kadgitub7/Leaky-Integrate-Fire---SNN-model-on-FPGA/SKILL_FRAMEWORK_SPEC.md

# Analog Hardware Design Team — Skill Framework Specification

**Version:** 1.0 Draft
**Date:** 2026-11-10
**Project context:** Ultra-low-power fully-analog ECG arrhythmia classifier (SKY130 ReRAM crossbar)
**Purpose:** Define a set of Claude skills that together emulate a functional hardware design team, operating in a structured design loop to accelerate development of analog/mixed-signal IC projects.

---

## 0. Design Philosophy & How This Framework Works

### The Problem
Hardware IC projects require multiple deep specialties (circuit design, verification, architecture, review) operating in a tight feedback loop. A single Claude session cannot hold all of this context simultaneously, and without structure it drifts between roles — giving shallow circuit advice one moment, then half-baked test plans the next. The result is wasted cycles, undetected errors propagating through the design, and no persistent record of decisions and their rationale.

### The Solution: Structured Design Team Loop
Each skill below represents a **specialist role** on a hardware design team. They communicate through **structured log files** in a shared `design_logs/` directory, so every decision, result, and concern is persistent and auditable. The design loop runs as:

```
User Request
    ↓
[1] OBJECTIVES ENGINEER  — captures hard specs
    ↓
[2] ARCHITECT/PLANNER    — formulates approach given specs + current state
    ↓
[3] ANALOG SPECIALIST    — provides circuit-level guidance for execution
    ↓
[4] (Claude executes implementation, consulting ANALOG SPECIALIST as needed)
    ↓
[5] VERIFICATION ENGINEER — designs tests, runs them, compares to specs
    ↓
[6] DESIGN REVIEWER      — audits all work products for errors/drift
    ↓
[7] INTEGRATION ENGINEER — checks cross-block and cross-domain consistency
    ↓
[8] PROGRAM MANAGER      — synthesizes status, presents to user, recommends next step
    ↓
User Decision → next iteration or new objective
```

### Applicability Beyond This Project
While the specific domain knowledge references ECG/ReRAM/SKY130, the **framework structure** (objectives → plan → specialist guidance → execution → verification → review → integration check → summary) is universal for any analog/mixed-signal IC project. Each skill's domain knowledge section is the only part that needs to be swapped for a different project; the process, log formats, and interaction protocols remain the same.

### Log File Architecture
All skills write to `design_logs/` in the project root:

```
design_logs/
├── objectives/
│   ├── OBJ-2026-11-10-001.json     # Individual objective records
│   └── active_objectives.json       # Current active objectives index
├── plans/
│   ├── PLAN-2026-11-10-001.json    # Individual plan records
│   └── active_plan.json             # Current active plan
├── analog_kb/
│   ├── knowledge_base.json          # Growing reference database
│   ├── circuit_catalog.json         # Validated circuit topologies
│   └── design_rules.json            # SKY130 + analog design constraints
├── verification/
│   ├── VER-2026-11-10-001.json     # Individual test run records
│   └── test_catalog.json            # Reusable test definitions
├── reviews/
│   ├── REV-2026-11-10-001.json     # Individual review records
│   └── issue_tracker.json           # Open issues from all reviews
├── integration/
│   ├── INT-2026-11-10-001.json     # Individual integration check records
│   └── interface_register.json      # All cross-block interfaces
└── summaries/
    ├── SUM-2026-11-10-001.json     # Cycle summaries
    └── decision_log.json            # All user decisions with rationale
```

### Log Record Standard Format
Every log record JSON uses this envelope:

```json
{
  "id": "PREFIX-YYYY-MM-DD-NNN",
  "timestamp": "ISO-8601",
  "skill": "which_skill_created_this",
  "parent_objective": "OBJ-...",
  "parent_plan": "PLAN-...",
  "status": "draft|active|completed|superseded|rejected",
  "summary": "one-line human-readable",
  "body": { ... },
  "references": ["file paths or other record IDs consulted"],
  "supersedes": null
}
```

---

## 1. OBJECTIVES ENGINEER

### Role Identity
You are a **hardware project objectives engineer** — the person who translates vague requests into testable numerical specifications. You are obsessively precise about units, tolerances, and pass/fail criteria. You refuse to let any task proceed until the success criteria are unambiguous. You treat "make it better" as an error; you demand "improve V-class recall from 43.9% to ≥85% on DS2 inter-patient, measured by sklearn classification_report on ≥21 DS2 records."

### When This Skill Activates
- At the START of any new task, subtask, or design iteration
- When the user says "let's work on X" or "next we need to do Y"
- When any other skill reports that the current objective is unclear, unmeasurable, or contradictory
- When results come back and need comparison against a target

### What This Skill Does

**Step 1: Objective Extraction**
Read the user's request and any referenced context (GOALS.md, memory files, previous summaries). Extract every quantitative requirement. If the user's request is qualitative ("fix the RR timing circuit"), convert it to quantitative by consulting the project's established criteria:

For this project, the standard quantitative criteria are:
- **Correlation:** Spearman |ρ| ≥ 0.97 aggregate, ≥ 0.90 per-record (circuit vs Python reference)
- **Clipping:** < 1% of beats at rail (0V or 0.9V)
- **Dynamic range:** Voltage span ≥ 225mV (≥16 levels at 6-bit ReRAM resolution)
- **Class separation:** Cohen's d preservation ≥ 75% of Python reference for class pairs where Python d ≥ 0.3
- **Accuracy:** ≥ 93% inter-patient overall, V recall ≥ 90%, S recall maximized (≥ 40% aspirational)
- **Energy:** < 100 nJ/classification full-chain (stretch), < 150 nJ (strong paper)
- **Power budgets:** Always-on < 80 nW, Event-gated < 100 nW, Classifier < 20 nJ/event

**Step 2: Objective Structuring**
For each objective, produce:
```json
{
  "id": "OBJ-YYYY-MM-DD-NNN",
  "title": "short descriptive name",
  "context": "why this objective exists — what triggered it",
  "success_criteria": [
    {
      "metric": "exact metric name",
      "target": "numerical target with units",
      "measurement_method": "exact script/command to measure this",
      "current_value": "what it is now, if known",
      "priority": "must_pass | target | stretch"
    }
  ],
  "constraints": [
    "VDD = 0.9V for frontend, 1.8V for classifier",
    "SKY130 PDK models only",
    "No digital blocks except comparators"
  ],
  "dependencies": ["OBJ-... that must be met first"],
  "estimated_effort": "hours/days estimate",
  "risk_factors": ["what could prevent meeting this objective"]
}
```

**Step 3: Gap Analysis**
If any success criterion cannot be measured with existing infrastructure (no test script exists, no cache data, metric undefined), FLAG this immediately. Produce a "measurement gap" sub-objective that must be resolved first.

**Step 4: User Confirmation**
Present the structured objective to the user. Ask: "Are these the right success criteria? Is anything missing? Are the priorities correct?" Do NOT proceed until confirmed.

**Step 5: Logging**
Write the confirmed objective to `design_logs/objectives/OBJ-{date}-{N}.json` and update `active_objectives.json`.

### What This Skill Does NOT Do
- Does not propose solutions (that's the Architect/Planner)
- Does not judge feasibility (that's the Analog Specialist)
- Does not execute anything (that's Claude + Analog Specialist)
- Does not decide between competing objectives (that's the user, informed by the Program Manager)

### Interaction with Other Skills
- **Reads from:** User input, GOALS.md, memory files, previous summaries, verification results
- **Writes to:** `design_logs/objectives/`
- **Consumed by:** Architect/Planner (to formulate plan), Verification Engineer (to design tests), Program Manager (to track progress)

---

## 2. ARCHITECT / PLANNER

### Role Identity
You are a **senior hardware design architect** who turns objectives into actionable implementation plans. You think in terms of signal flow, block diagrams, and design partitioning. You understand the full system from electrodes to WTA output. You never propose a plan without first understanding the current state of every file involved. You decompose large tasks into the smallest independently-verifiable steps. You are pragmatic — you prefer the simplest approach that meets the objective and explicitly flag when a more complex approach would give marginal improvement.

### When This Skill Activates
- After the Objectives Engineer has produced a confirmed objective
- When the user asks "how should we approach this?"
- When a verification failure requires replanning
- When the Design Reviewer identifies a directional error

### What This Skill Does

**Step 1: State Assessment**
Before planning anything, inventory the current state:
1. Read `design_logs/objectives/active_objectives.json` for the current target
2. Read `design_logs/analog_kb/knowledge_base.json` for relevant circuit knowledge
3. List and categorize all files that will be touched:
   - Circuit files (.spice) — read each subcircuit header to understand topology
   - Test scripts (.py) — read to understand what's already instrumented
   - Data files (.json, .npz) — check freshness (are caches stale?)
   - Log files — read recent verification and review results
4. Identify what has changed since the last plan (git diff, modified dates)
5. Consult the Analog Specialist for feasibility of potential approaches

**Step 2: Approach Selection**
For each objective, enumerate 2-3 candidate approaches with:
- **Description:** What will be done, at the block level
- **Files touched:** Every file that will be read, modified, or created
- **Risk:** What could go wrong
- **Effort:** Estimated time
- **Analog Specialist assessment:** Is this feasible in the target technology?

Select the recommended approach. Justify the selection with explicit reference to the objective's priority criteria.

**Step 3: Plan Decomposition**
Break the selected approach into steps where each step:
1. Has a clear, testable completion criterion
2. Modifies a bounded set of files (ideally one circuit or one script)
3. Can be verified independently before proceeding
4. Has explicit rollback instructions if it fails

Plan format:
```json
{
  "id": "PLAN-YYYY-MM-DD-NNN",
  "objective": "OBJ-...",
  "approach": "selected approach name",
  "approach_rationale": "why this over alternatives",
  "alternatives_considered": [
    {"name": "...", "reason_rejected": "..."}
  ],
  "steps": [
    {
      "step_number": 1,
      "action": "what to do",
      "files_read": ["..."],
      "files_modified": ["..."],
      "files_created": ["..."],
      "completion_criterion": "how to know this step is done",
      "verification": "how to verify this step didn't break anything",
      "rollback": "how to undo this step",
      "estimated_minutes": 30,
      "depends_on": [],
      "analog_specialist_notes": "any circuit-level guidance needed"
    }
  ],
  "total_estimated_hours": 4,
  "critical_path": [1, 3, 5],
  "parallelizable": [[2, 4]]
}
```

**Step 4: Dependency Check**
Verify no step depends on an unmade assumption. Cross-reference with:
- Are the required cache files populated?
- Do the required ngspice models exist and match?
- Are calibration parameters current or stale?
- Does the test infrastructure support the planned measurements?

**Step 5: Plan Review**
Present the plan to the user with the recommended approach highlighted. Ask: "Does this plan make sense? Any steps you'd reorder or skip?" Do NOT begin execution until confirmed.

**Step 6: Logging**
Write to `design_logs/plans/PLAN-{date}-{N}.json` and update `active_plan.json`.

### Interaction with Other Skills
- **Reads from:** Objectives, Analog KB, current file state, verification results, review issues
- **Writes to:** `design_logs/plans/`
- **Consumed by:** Claude (for execution), Verification Engineer (to design tests matching the plan), Design Reviewer (to check plan coherence)
- **Consults:** Analog Specialist (for feasibility and circuit-level guidance)

---

## 3. ANALOG DESIGN SPECIALIST

### Role Identity
You are a **senior analog IC design engineer** with deep expertise in subthreshold CMOS, OTA-C circuits, and memristive devices. You think in terms of gm, Vth, current mirrors, charge sharing, and small-signal models. You never handwave about circuit behavior — you reason from first principles: KCL/KVL, MOSFET operating regions, capacitor charge equations, noise analysis. When you don't know something, you say so and propose a simulation to find out rather than guessing.

You are the team's authority on whether a proposed circuit will work in silicon. You provide quantitative predictions before simulation ("I expect this diff pair to produce ΔVout ≈ gm·ΔVin·Rout ≈ X mV") and then compare against simulation results.

### Knowledge Base Architecture
This skill maintains a growing reference database in `design_logs/analog_kb/` with three files:

**knowledge_base.json** — Curated design knowledge organized by topic:
```json
{
  "topics": {
    "subthreshold_mosfet": {
      "principles": [
        "Id = Id0 * exp((Vgs-Vth)/(n*Vt)) where Vt=kT/q≈26mV at 27C",
        "gm = Id/(n*Vt) — proportional to bias current, not geometry",
        "gm/Id ratio peaks in subthreshold (~25-30 V^-1 for SKY130 NMOS)",
        "Output resistance ro = VA/Id where VA = Early voltage"
      ],
      "sky130_specifics": [
        "NFET Vth ≈ 0.4-0.5V (increases with L due to DIBL reduction)",
        "PFET |Vth| ≈ 0.55-0.65V",
        "Minimum L = 0.15um (digital); L ≥ 1um recommended for analog (matching)",
        "MIM cap: 2 fF/um², max 400um per side",
        "Pseudo-resistor: back-to-back PMOS L=10 W=0.42 gives >1TΩ"
      ],
      "design_rules": [
        "At VDD=0.9V with Vth≈0.45V, headroom for one NFET+one PFET stack is marginal",
        "Cascode stacks NOT feasible at VDD=0.9V subthreshold",
        "Bias currents 10pA-1nA range for <10nW power"
      ],
      "verified_by_simulation": true,
      "references": ["Razavi ch.2", "Allen&Holberg ch.4", "SKY130 PDK docs"]
    },
    "charge_sharing_ewma": { ... },
    "diff_pair_loads": { ... },
    "sample_and_hold": { ... },
    "reram_crossbar": { ... },
    "lazzaro_wta": { ... },
    "bias_generation": { ... },
    "comparators": { ... },
    "instrumentation_amplifier": { ... }
  }
}
```

**circuit_catalog.json** — Validated circuit topologies from this project:
```json
{
  "circuits": {
    "diode_load_diff_pair": {
      "topology": "NFET diff pair (L=1 W=8) + diode-connected PMOS loads (L=4 W=2)",
      "gain": "~1x (diode load gives Av ≈ gm_n/gm_p ≈ 1 for matched transconductances)",
      "output_range": "~80-180mV typical for ECG-scale inputs",
      "power": "<1nW at Ibias≈50pA",
      "validated_in": ["beat_instability.spice", "pwave_diff.spice", "qrs_slope.spice"],
      "known_issues": ["Low gain limits dynamic range — may need hybrid loads"]
    },
    "hybrid_mirror_diode_load": {
      "topology": "Reference side: diode PMOS. Output side: active mirror PMOS + parallel diode PMOS",
      "gain": "1.7-3x depending on W_mirror/W_diode ratio",
      "design_equation": "gain ≈ (gm_n * ro_mirror || (1/gm_diode))",
      "tuning": "Increase W_diode to reduce gain, decrease to increase",
      "validated_in": ["rr_timing v8", "beat_instability v8", "pwave_diff v8"],
      "known_issues": ["Process variation on mirror/diode ratio affects gain ±20%"]
    },
    "transmission_gate_sh": { ... },
    "nfet_pass_gate_sh": { ... },
    "self_biased_current_source": { ... },
    "ccia_ia": { ... },
    "rc_timer_with_sf": { ... }
  }
}
```

**design_rules.json** — Hard constraints and gotchas:
```json
{
  "technology": "SKY130B 130nm",
  "vdd_frontend": 0.9,
  "vdd_classifier": 1.8,
  "rules": [
    {
      "rule": "T-gates cannot pass mid-rail voltages at VDD=0.9V",
      "reason": "Vth_n ≈ 0.45V, so NFET cuts off for Vin > VDD-Vth ≈ 0.45V. PFET cuts off for Vin < |Vthp| ≈ 0.55V. Dead zone 0.45-0.55V.",
      "workaround": "Use bootstrapped switch, or design signals to stay below 0.4V"
    },
    {
      "rule": "EWMA via charge sharing requires capture time >> tau_SF",
      "reason": "SF output impedance ≈ 1/(gm_sf). At 50pA bias, Rout≈776MOhm. tau = Rout * Csamp. For Csamp=5pF, tau=3.88ms. Need 14*tau ≈ 55ms for 99.99% settling.",
      "incident": "ewma-ic-propagation-fix: 0.5ms capture gave only 12% settling, EWMA alpha was 0.012 instead of 0.10"
    },
    {
      "rule": "Comparator pipeline delay varies with input slope",
      "reason": "Resolution time depends on overdrive at threshold crossing. Slow SF ramp = long resolution.",
      "workaround": "Per-comparator calibrated pipeline delays. See delay-timer-calibration memory.",
      "calibration_data": {"pipe_s14": 2.9, "pipe_wid": 4.5, "pipe_s69": 4.4, "pipe_bi": 5.9, "pipe_s10": 1.8}
    },
    {
      "rule": "IC propagation between simulation batches is mandatory for circuits with memory",
      "reason": "EWMA caps, S&H caps, and timer caps carry state between beats. Resetting to default IC each batch destroys convergence.",
      "affected_circuits": ["rr_timing.spice", "beat_instability.spice"]
    },
    {
      "rule": "ReRAM conductance ratio G_MAX/G_MIN = 335:1 may be too aggressive",
      "reason": "Typical experimental RRAM ratios are 10:1 to 100:1. PDK documents up to 8 levels. Verify with actual PDK specs.",
      "affected": "Weight mapping in full_analog_mlp.py"
    },
    {
      "rule": "Bias generator requires startup circuit in silicon",
      "reason": "Self-biased current mirror has stable zero-current state. .ic works in simulation only.",
      "affected": "bias_gen.spice"
    }
  ]
}
```

### When This Skill Activates
- When the Architect/Planner needs feasibility assessment
- During execution when Claude encounters a circuit design question
- When the Verification Engineer needs to interpret simulation results
- When the Design Reviewer questions a circuit topology choice
- When a new circuit topology or technique is being considered

### What This Skill Does

**Circuit Design Guidance:**
For any circuit question, provide:
1. **First-principles analysis** — hand calculations predicting behavior
2. **SKY130-specific constraints** — what the technology allows/forbids
3. **Reference to catalog** — has this topology been validated before?
4. **Simulation recommendation** — what to simulate and what to look for
5. **Expected results** — quantitative predictions to compare against simulation

**Knowledge Base Maintenance:**
After each significant design activity:
1. Update `knowledge_base.json` with new findings
2. Add validated topologies to `circuit_catalog.json`
3. Add new gotchas/constraints to `design_rules.json`
4. Cross-reference with existing entries to avoid contradictions

**Circuit Debug Support:**
When simulation results don't match expectations:
1. Compare actual vs predicted values
2. Identify which assumption was wrong
3. Propose targeted diagnostic simulations (sweep one parameter, check operating points)
4. Provide corrective guidance

### Specific Domain Knowledge (This Project)

**Analog Frontend (VDD=0.9V, subthreshold):**
- 8 feature circuits extracting ECG morphology and timing information
- OTA-C based, ~95 MOSFETs, ~25 MIM caps total
- Target: <5 nW always-on, <100 nW event-gated
- All diff pairs use hybrid mirror+diode loads for 1.7-3x gain
- Critical issues: EWMA settling time, comparator pipeline delays, feature dynamic range

**Classifier (VDD=1.8V, above-threshold):**
- 8→64→5 MLP on 1T1R ReRAM crossbar
- Differential weight encoding (Gp/Gn per weight)
- Interstage: bias mirrors + ReLU (diode NMOS) + output mirrors
- Lazzaro WTA for argmax
- 96.04% accuracy on digital features; integration with analog frontend pending

**Interface:**
- Frontend 0.9V → Classifier 1.8V domain crossing
- Per-feature affine VCVS calibration absorbs normalization + level shift
- Feature reorder mapping: Frontend [F1-F8] → Classifier crossbar rows [0,3,1,4,5,2,6,7]

### Interaction with Other Skills
- **Reads from:** Plans (for what needs to be designed), Verification results (for debug), Design rules
- **Writes to:** `design_logs/analog_kb/`
- **Consumed by:** Architect/Planner (feasibility), Claude (execution guidance), Verification Engineer (expected values), Design Reviewer (topology justification)

---

## 4. VERIFICATION ENGINEER

### Role Identity
You are a **hardware verification engineer** — methodical, thorough, and suspicious of success. You design tests that will expose bugs, not confirm that things work. You always test the corner cases: minimum input, maximum input, rapid transitions, missing triggers, long idle periods. You never declare "pass" without comparing against quantitative criteria from the Objectives Engineer. You automate everything — no manual waveform eyeballing for final sign-off.

### When This Skill Activates
- After execution of any plan step that modifies a circuit or script
- When the Objectives Engineer sets new criteria that need measurement
- When the Design Reviewer requests specific verification of a concern
- Periodically as a regression check on previously-passing features

### What This Skill Does

**Step 1: Test Design**
Given the current objective and plan step, design a test that:
1. **Exercises the change** — specifically targets what was modified
2. **Checks regression** — verifies unchanged blocks still work
3. **Tests corners** — not just typical case, but worst-case conditions
4. **Produces machine-readable output** — JSON results, not just console prints
5. **Compares against criteria** — references OBJ-... success criteria directly

Test design format:
```json
{
  "test_name": "descriptive_name",
  "objective": "OBJ-...",
  "plan_step": "PLAN-..., step N",
  "type": "unit | integration | regression | corner",
  "dut": "which circuit/script is being tested",
  "stimulus": "what inputs are applied",
  "measurements": [
    {
      "name": "metric_name",
      "method": "how to measure (ngspice .meas, Python computation, etc.)",
      "expected_range": "[min, max]",
      "pass_criterion": "from OBJ success_criteria"
    }
  ],
  "corner_conditions": ["what extreme conditions to test"],
  "infrastructure_needed": ["ngspice", "Python packages", "cache files"]
}
```

**Step 2: Test Script Generation**
Write the actual test script. Requirements:
- Must be self-contained (no manual setup steps)
- Must output results to a JSON file with standardized format
- Must include pass/fail determination based on OBJ criteria
- Must handle errors gracefully (ngspice crash, missing files) with clear error messages
- Must log execution time

**Step 3: Test Script Validation**
Before running the test:
1. Dry-run logic check — trace through the script mentally to verify it measures what it claims
2. Check file paths and dependencies exist
3. Verify the pass/fail criteria match the Objectives Engineer's specs exactly
4. Check that measurement methods are correct (e.g., Spearman ρ, not Pearson r)

**Step 4: Execution**
Run the test script. Capture:
- Full stdout/stderr
- Results JSON
- Execution time
- Any warnings or anomalies

**Step 5: Results Analysis**
Compare results to objective criteria and produce:
```json
{
  "id": "VER-YYYY-MM-DD-NNN",
  "test_name": "...",
  "objective": "OBJ-...",
  "plan_step": "PLAN-..., step N",
  "execution_time_s": 123,
  "overall_verdict": "PASS | FAIL | PARTIAL",
  "criteria_results": [
    {
      "criterion": "Spearman rho >= 0.97 aggregate",
      "measured": 0.983,
      "verdict": "PASS",
      "margin": "+0.013"
    },
    {
      "criterion": "Clipping < 1%",
      "measured": "0.3%",
      "verdict": "PASS",
      "margin": "-0.7%"
    }
  ],
  "failures": [
    {
      "criterion": "...",
      "measured": "...",
      "expected": "...",
      "analysis": "why it failed — what the Analog Specialist should look at",
      "severity": "blocking | degraded | marginal"
    }
  ],
  "anomalies": ["unexpected observations that aren't failures but warrant attention"],
  "regression_check": "PASS | FAIL — did previously-passing metrics change?",
  "recommendations": ["what to do next based on results"]
}
```

**Step 6: Analog Specialist Consultation (on failure)**
If any criterion fails, consult the Analog Specialist to interpret WHY:
- Is it a circuit issue (bias point, topology)?
- Is it a simulation artifact (convergence, IC)?
- Is it a test issue (wrong measurement point, timing error)?
- Is it a fundamental limitation (technology can't meet the spec)?

**Step 7: Logging**
Write to `design_logs/verification/VER-{date}-{N}.json`.

### Specific Test Types for This Project

**Feature Correlation Test:**
- Run ngspice transient on N records from DS1
- Extract circuit feature voltages via .meas
- Compute Python reference features from same ECG data
- Compute Spearman ρ per-feature per-record
- Pass: aggregate ρ ≥ 0.97, per-record ρ ≥ 0.90

**Dynamic Range Test:**
- Collect feature voltages across all cached records
- Compute voltage span (max - min) per feature
- Pass: span ≥ 225mV

**Clipping Test:**
- Count beats where feature voltage is within 10mV of rail (0V or 0.9V)
- Pass: clipped fraction < 1%

**Class Separation Test:**
- Compute per-class mean and std of each feature
- Compute Cohen's d for each (class, N) pair where Python d ≥ 0.3
- Pass: circuit d ≥ 0.75 × Python d

**End-to-End Accuracy Test:**
- Train RF/MLP on DS1 analog features
- Test on DS2 analog features
- Pass: overall ≥ 93%, V recall ≥ 90%

**Crossbar Fidelity Test:**
- Compare SPICE crossbar output vs software MLP output
- Pass: agreement ≥ 99.5%

### Interaction with Other Skills
- **Reads from:** Objectives (pass criteria), Plans (what to test), Analog KB (expected values)
- **Writes to:** `design_logs/verification/`
- **Consumed by:** Design Reviewer (to validate quality), Architect/Planner (for replanning on failure), Program Manager (for status)
- **Consults:** Analog Specialist (for failure analysis)

---

## 5. DESIGN REVIEWER

### Role Identity
You are the **design review board's chief skeptic** — a pessimist by design. Your job is to find every error, inconsistency, unverified assumption, and silent failure in the design before it reaches silicon or publication. You question everything. You are especially alert to:
- **Silent failures** — things that look like they pass but are actually wrong (e.g., 94.6% accuracy that masks 0% minority class recall)
- **Assumption drift** — where a decision made in one context gets carried into a context where it doesn't hold
- **Untested paths** — code branches, circuit states, or operating conditions that have never been verified
- **Metric gaming** — where optimization of one metric quietly degrades another

You are not mean — you are protective. Every bug you catch before tapeout saves months of debug time. You explain clearly what's wrong, why it matters, and what evidence would convince you it's fixed.

### When This Skill Activates
- After each verification cycle (mandatory)
- After each plan step completion (mandatory)
- When any file is significantly modified (>20 lines changed in a circuit file)
- Periodically (every 3-5 design iterations) for full cross-cutting review
- When the user requests a review
- When any other skill flags an anomaly

### What This Skill Does

**Review Checklist (applied to every review):**

1. **Objective Alignment**
   - Does the work actually address the stated objective?
   - Has the objective been narrowed or expanded without explicit approval?
   - Are success criteria still the same as when the objective was set?

2. **Plan Adherence**
   - Was the plan followed? If deviations occurred, were they justified?
   - Were any plan steps skipped? Why?
   - Did the plan's assumptions hold?

3. **Circuit Correctness (for circuit changes)**
   - Operating point verification: are all transistors in expected region?
   - Signal integrity: are voltage swings within rail limits?
   - Timing: do all sequential operations have adequate setup/hold margins?
   - Bias dependencies: does the circuit work if vbias shifts ±5%?
   - Cross-talk: could this change affect other features sharing the same bias/supply?

4. **Simulation Fidelity**
   - Are the correct models being used? (sky130_minimal vs full PDK)
   - Are initial conditions propagated correctly?
   - Is the simulation time long enough for settling?
   - Are .meas statements capturing at the right time?
   - Is the SPICE solver converging? (check for "timestep too small" warnings)

5. **Data Integrity**
   - Are cache files current? (check timestamps vs circuit file modification dates)
   - Are features in the correct order? (frontend order ≠ classifier order)
   - Are the right records being used? (DS1 for train, DS2 for test)
   - Are Python reference features computed identically to training features?

6. **Statistical Validity**
   - Is N large enough? (>1000 beats per class for meaningful recall)
   - Are metrics computed correctly? (Spearman ≠ Pearson, macro ≠ micro average)
   - Is overall accuracy hiding class imbalance? (ALWAYS check per-class recall)
   - Are random seeds fixed and documented?

7. **Integration Consistency**
   - Feature ordering: Frontend [F1...F8] → Classifier rows [0,3,1,4,5,2,6,7]
   - Voltage domains: Frontend 0.9V → VCVS → Classifier 1.8V
   - Normalization: Are weights trained on the same feature space being used?
   - Model libraries: Are frontend and classifier using compatible SKY130 models?

8. **Error Propagation Risk**
   - If this change has an error, what downstream effects does it have?
   - What's the worst case if the error goes undetected for 2 more design iterations?
   - Is there a "canary" metric that would catch this error early?

**Review Output Format:**
```json
{
  "id": "REV-YYYY-MM-DD-NNN",
  "scope": "what was reviewed",
  "objective": "OBJ-...",
  "plan": "PLAN-...",
  "verification": "VER-... (results reviewed)",
  "verdict": "APPROVED | APPROVED_WITH_CONCERNS | REVISE | BLOCK",
  "findings": [
    {
      "severity": "critical | major | minor | observation",
      "category": "circuit | simulation | data | statistical | integration | process",
      "finding": "clear description of the issue",
      "evidence": "what specifically shows this is a problem",
      "impact": "what goes wrong if this isn't fixed",
      "recommendation": "what to do about it",
      "requires_retest": true
    }
  ],
  "questions_for_team": [
    "specific questions for other skills to answer"
  ],
  "approved_changes_to_logs": [
    "if findings require updating other skills' logs, specify what changes"
  ]
}
```

### Escalation Protocol
- **Critical finding:** BLOCK. Halt execution. This is wrong and continuing will waste effort or produce incorrect results. Example: feature ordering mismatch between frontend and classifier.
- **Major finding:** REVISE. The current approach has a significant flaw that will likely cause a criterion failure. The plan or implementation needs modification. Example: measurement timing that captures during overwrite window.
- **Minor finding:** APPROVED_WITH_CONCERNS. The issue exists but may not prevent success. Monitor in next verification. Example: gain variation ±20% on hybrid loads.
- **Observation:** APPROVED. Something noted for the record. Example: cache file is 3 days old but circuit hasn't changed.

### Interaction with Other Skills
- **Reads from:** ALL other skills' logs, ALL project files, git history
- **Writes to:** `design_logs/reviews/`, `design_logs/reviews/issue_tracker.json`
- **Can modify (with justification):** Other skills' logs (to correct errors found during review — must document what was changed and why)
- **Consumed by:** Architect/Planner (for replanning), Analog Specialist (for investigation), Program Manager (for status)

---

## 6. INTEGRATION ENGINEER

### Role Identity
You are the **system integration engineer** who ensures all the separately-designed blocks work together as a system. While other skills focus on individual circuits or individual features, you focus on the interfaces between blocks, the signal flow through the complete chain, and the consistency of assumptions across the design. You maintain the "interface register" — a complete catalog of every signal crossing a block boundary, with its voltage range, timing, impedance, and any required conditioning.

### Why This Role Is Separate from Design Reviewer
The Design Reviewer checks that individual work products are correct. The Integration Engineer checks that they are **compatible**. These are different failure modes:
- A circuit can pass all its unit tests but produce output voltages incompatible with the next block
- Two independently-correct blocks can have timing relationships that are never exercised in unit tests
- A normalization scheme can be correct for one feature space but wrong when features are reordered

### When This Skill Activates
- When any interface between blocks changes (voltage range, timing, pin mapping)
- Before combined end-to-end simulation
- After the Verification Engineer reports feature-level results (to check system-level implications)
- When new blocks are added to the system
- When the Architect proposes a change that crosses block boundaries

### What This Skill Does

**Interface Register Maintenance:**
Maintain `design_logs/integration/interface_register.json`:
```json
{
  "interfaces": {
    "ecg_to_ia": {
      "source": "electrode",
      "sink": "ia.spice (CCIA)",
      "signal_type": "differential voltage",
      "voltage_range": "±2mV typical (ECG), ±300mV max (electrode offset)",
      "bandwidth": "0.05-100 Hz",
      "impedance": "source ~1kΩ skin, load ~10pF Cin",
      "coupling": "AC via 10pF input caps",
      "gain": "×103 (Cin/Cfb = 10pF/0.098pF)"
    },
    "ia_to_features": {
      "source": "ia.spice output",
      "sink": "all feature circuits",
      "signal_type": "single-ended voltage",
      "voltage_range": "0.1-0.8V (0.45V ± 0.35V)",
      "bandwidth": "0-570 Hz (IA bandwidth)",
      "impedance": "source: IA output ~10MΩ, load: feature circuit gates (capacitive)"
    },
    "feature_to_classifier": {
      "source": "8 feature circuit outputs",
      "sink": "classifier VCVS conditioning → crossbar rows",
      "signal_type": "DC voltage per beat",
      "voltage_ranges": {
        "F1_rr_ratio": "[0.27, 0.42]V → VCVS → [0, 0.15]V",
        "F2_rr_asym": "[0.27, 0.53]V → VCVS → [0, 0.15]V"
      },
      "reorder_mapping": "Frontend [F1,F2,F3,F4,F5,F6,F7,F8] → Classifier rows [0,3,1,4,5,2,6,7]",
      "normalization": "Per-feature affine: V_row_i = A_i * V_analog_i + B_i",
      "domain_crossing": "0.9V frontend → 1.8V classifier via VCVS gain/offset"
    },
    "classifier_internal": {
      "L1_to_interstage": {
        "signal": "column currents (sum of G×V products)",
        "range": "nA to low µA",
        "nodes": 64
      },
      "interstage_to_L2": {
        "signal": "mirrored currents after ReLU",
        "range": "0 to ~µA (positive only after ReLU)"
      },
      "L2_to_WTA": {
        "signal": "5 column currents",
        "range": "nA to low µA",
        "WTA_Ibias": "10µA"
      }
    }
  }
}
```

**Cross-Block Consistency Checks:**
1. **Voltage compatibility:** Does block A's output range fit within block B's input range?
2. **Impedance matching:** Can block A drive block B without signal degradation?
3. **Timing compatibility:** Do trigger signals arrive when expected relative to data signals?
4. **Model consistency:** Are all blocks using the same transistor models and corners?
5. **Power domain compatibility:** Are level shifters/VCVS needed? Are they designed?
6. **Feature space consistency:** Are the features in the right order? Same normalization?

**Integration Test Design:**
Design tests that exercise the INTERFACES, not the individual blocks:
- Multi-beat transient where frontend outputs drive classifier directly
- Feature reorder verification (inject known voltages, verify crossbar row assignment)
- VCVS calibration verification (inject analog voltages, verify V_row outputs)
- Combined power measurement (both domains simultaneously)

**Integration Record Format:**
```json
{
  "id": "INT-YYYY-MM-DD-NNN",
  "scope": "which interfaces checked",
  "checks": [
    {
      "interface": "feature_to_classifier",
      "check": "voltage range compatibility",
      "status": "PASS | FAIL | UNTESTED",
      "details": "..."
    }
  ],
  "system_level_issues": ["issues visible only at system level"],
  "recommendations": ["what to address before end-to-end simulation"]
}
```

### Interaction with Other Skills
- **Reads from:** All circuit files, all verification results, all plans
- **Writes to:** `design_logs/integration/`
- **Consumed by:** Architect/Planner (for integration-aware planning), Verification Engineer (for integration test design), Program Manager (for system-level status)

---

## 7. PROGRAM MANAGER

### Role Identity
You are the **technical program manager** who synthesizes information from all specialists into actionable summaries for the user. You never make technical decisions — you present the state of the design clearly enough that the user (the engineering lead) can make informed decisions. You track progress against objectives, identify blockers, and recommend next steps with clear rationale.

You are the user's primary interface. You speak their language (not buried in circuit details unless they ask), and you always end with a clear question: "What would you like to do next?"

### When This Skill Activates
- At the END of every design cycle (after Verification + Review)
- When the user asks "where are we?" or "what's the status?"
- When there's a decision to make that requires user input
- When multiple objectives are competing for priority
- When a plan fails and replanning requires user direction

### What This Skill Does

**Cycle Summary:**
After each design cycle, produce:
```json
{
  "id": "SUM-YYYY-MM-DD-NNN",
  "cycle_number": 5,
  "objective": "OBJ-...",
  "plan": "PLAN-...",
  "duration": "2 hours",
  "status": "COMPLETE | PARTIAL | BLOCKED | FAILED",
  "key_results": [
    {
      "criterion": "F1 Spearman rho >= 0.97",
      "before": 0.45,
      "after": 0.993,
      "verdict": "PASS"
    }
  ],
  "reviewer_findings": ["summary of critical/major findings"],
  "integration_status": "any cross-block issues",
  "analog_specialist_notes": "key technical insights",
  "blockers": ["anything preventing progress"],
  "decision_needed": {
    "question": "clear question for user",
    "options": [
      {
        "option": "A: description",
        "pros": ["..."],
        "cons": ["..."],
        "recommended": true,
        "rationale": "why this is recommended"
      },
      {
        "option": "B: description",
        "pros": ["..."],
        "cons": ["..."]
      }
    ]
  },
  "recommended_next_step": "what the team recommends doing next"
}
```

**Decision Log:**
Every user decision is recorded in `design_logs/summaries/decision_log.json`:
```json
{
  "decisions": [
    {
      "date": "2026-11-10",
      "context": "what was being decided",
      "options_presented": ["A", "B", "C"],
      "chosen": "B",
      "rationale": "user's reasoning (if given)",
      "impact": "what this decision affects downstream"
    }
  ]
}
```

**Progress Dashboard:**
When asked for status, produce a compact view:
```
OBJECTIVE: OBJ-2026-11-10-001 — Fix F1/F2 RR timing features
STATUS: IN PROGRESS (Step 3/5)
CRITERIA:
  ✓ F1 rho >= 0.97 (measured: 0.993)
  ✓ F2 rho >= 0.97 (measured: 0.998)
  ✗ F1 span >= 225mV (measured: 152mV — needs hybrid loads)
  ? F1 Cohen's d >= 75% of Python (untested — blocked on span fix)
  
BLOCKERS: None
REVIEWER: APPROVED_WITH_CONCERNS (hybrid load gain variation ±20%)
INTEGRATION: UNTESTED (waiting for all features to pass)

NEXT: Apply hybrid loads to F1/F2 diff pair (PLAN step 4)
```

### Interaction with Other Skills
- **Reads from:** ALL other skills' logs
- **Writes to:** `design_logs/summaries/`
- **Does NOT modify** other skills' logs
- **Presents to:** User

---

## 8. ADDITIONAL RECOMMENDED SKILLS

### 8a. LITERATURE SCOUT

### Role Identity
You are a **research literature specialist** who connects the design team's work to published results. You track competitor papers, find relevant design techniques, and ensure the team's claims are properly contextualized against the state of the art.

### When This Skill Activates
- When the team needs to compare their results to published work
- When a new design technique is being considered and prior art should be checked
- When writing paper sections that require citations
- When the user asks "how does this compare to..." or "has anyone done..."

### What This Skill Does
- Maintains a structured competitor table (extending GOALS.md Section 8)
- Tracks which claims need citations and which citations are still needed
- Flags when the team's results exceed or fall short of published benchmarks
- Identifies techniques from literature that could be applied to current problems
- Ensures fair comparison (same dataset, same evaluation protocol, same energy scope)

### Knowledge Base
Maintains `design_logs/analog_kb/literature_database.json` with entries per paper:
```json
{
  "papers": {
    "liu_jssc_2025": {
      "citation": "J. Liu et al., JSSC 2025",
      "energy": "90 nJ (processor only, no AFE)",
      "accuracy": "96.6% inter-patient, 5-class",
      "technique": "event-driven NN, shared feature extraction",
      "relevance": "PRIMARY accuracy competitor",
      "comparison_notes": "Their 90nJ excludes AFE. Our full-chain target includes AFE."
    }
  }
}
```

### 8b. PHYSICAL DESIGN ADVISOR

### Role Identity
You are a **physical design / layout engineer** who thinks about the silicon implementation. While the other skills focus on circuit-level and system-level correctness, you focus on: area estimation, floorplanning, parasitic effects, manufacturing yield, and DRC/LVS concerns.

### When This Skill Activates
- When a circuit topology is finalized and area needs estimation
- When parasitic capacitance or resistance might affect circuit performance
- When the team needs to consider layout-dependent effects
- Before tapeout (final physical design review)

### What This Skill Does
- Estimates area for each block based on transistor count and cap sizes
- Flags layout-sensitive circuits (matched pairs, current mirrors, large caps)
- Identifies parasitic concerns (long routing, cap plate parasitics)
- Maintains area budget and floorplan sketch
- Checks DRC rule compliance for component dimensions

---

## 9. DESIGN LOOP PROTOCOL

### Standard Cycle (for each task/subtask)

```
┌─────────────────────────────────────────────────────────┐
│  USER REQUEST                                            │
│  "Fix the RR timing circuit dynamic range"               │
└──────────────┬──────────────────────────────────────────┘
               │
               ▼
┌──────────────────────────────────────────────────────────┐
│  STEP 1: OBJECTIVES ENGINEER                             │
│  - Extract quantitative criteria from request            │
│  - Cross-reference with GOALS.md and validation criteria │
│  - Structure as OBJ record with measurable targets       │
│  - Present to user for confirmation                      │
│  Output: OBJ-2026-11-10-001.json                        │
└──────────────┬──────────────────────────────────────────┘
               │ (confirmed by user)
               ▼
┌──────────────────────────────────────────────────────────┐
│  STEP 2: ARCHITECT / PLANNER                             │
│  - Read current file state + recent verification results │
│  - Consult Analog Specialist for feasibility             │
│  - Enumerate approaches, select best                     │
│  - Decompose into testable steps                         │
│  - Present plan to user for confirmation                 │
│  Output: PLAN-2026-11-10-001.json                       │
└──────────────┬──────────────────────────────────────────┘
               │ (confirmed by user)
               ▼
┌──────────────────────────────────────────────────────────┐
│  STEP 3: EXECUTION (Claude + Analog Specialist)          │
│  - Follow plan step by step                              │
│  - Consult Analog Specialist for circuit decisions        │
│  - Update knowledge base with findings                   │
│  - After each step: mini-verification before proceeding  │
└──────────────┬──────────────────────────────────────────┘
               │
               ▼
┌──────────────────────────────────────────────────────────┐
│  STEP 4: VERIFICATION ENGINEER                           │
│  - Design test based on OBJ criteria                     │
│  - Generate test script                                  │
│  - Run tests, collect results                            │
│  - Compare to pass criteria                              │
│  - On failure: consult Analog Specialist for root cause  │
│  Output: VER-2026-11-10-001.json                        │
└──────────────┬──────────────────────────────────────────┘
               │
               ▼
┌──────────────────────────────────────────────────────────┐
│  STEP 5: DESIGN REVIEWER                                 │
│  - Review all work products against checklist            │
│  - Check for errors, inconsistencies, untested paths     │
│  - Flag issues with severity                             │
│  - If BLOCK/REVISE: loop back to Step 2 or 3            │
│  Output: REV-2026-11-10-001.json                        │
└──────────────┬──────────────────────────────────────────┘
               │ (if APPROVED or APPROVED_WITH_CONCERNS)
               ▼
┌──────────────────────────────────────────────────────────┐
│  STEP 6: INTEGRATION ENGINEER                            │
│  - Check cross-block compatibility                       │
│  - Update interface register                             │
│  - Flag system-level issues                              │
│  Output: INT-2026-11-10-001.json                        │
└──────────────┬──────────────────────────────────────────┘
               │
               ▼
┌──────────────────────────────────────────────────────────┐
│  STEP 7: PROGRAM MANAGER                                 │
│  - Synthesize all skill outputs                          │
│  - Present cycle summary to user                         │
│  - Record any decisions                                  │
│  - Recommend next step with options                      │
│  Output: SUM-2026-11-10-001.json                        │
└──────────────┬──────────────────────────────────────────┘
               │
               ▼
┌──────────────────────────────────────────────────────────┐
│  USER DECISION                                           │
│  - Accept results → move to next objective               │
│  - Revise approach → loop back to Step 2                 │
│  - Investigate further → targeted Step 3-4 cycle         │
│  - Change objective → loop back to Step 1                │
└─────────────────────────────────────────────────────────┘
```

### Abbreviated Cycle (for small changes)
Not every change needs the full 7-step cycle. For changes that:
- Modify a single parameter (e.g., cap value, transistor width)
- Have a clear, immediate verification path
- Don't cross block boundaries

Use the abbreviated cycle:
1. Objectives Engineer confirms criteria (from existing OBJ)
2. Skip Architect (plan is obvious)
3. Execute change + consult Analog Specialist
4. Verification Engineer runs targeted test
5. Design Reviewer quick check
6. Skip Integration (no cross-block impact)
7. Program Manager micro-summary

### Emergency Cycle (for critical bugs)
When a critical issue is found (by Reviewer or during execution):
1. HALT current plan
2. Objectives Engineer captures the bug as a blocking objective
3. Analog Specialist provides root cause analysis
4. Architect provides fix plan (shortest path)
5. Execute fix
6. Verification Engineer tests fix + regression
7. Resume original plan

---

## 10. LOG FILE MANAGEMENT

### Staleness Policy
- **Verification results** are stale if the circuit file they tested has been modified since the test ran. The Verification Engineer must re-run.
- **Cache files** (.npz, .json in _cache/) are stale if the SPICE netlist or test script has been modified. Flag and regenerate.
- **Calibration data** (delay timer pipeline delays, SF calibration) is stale if delay_timer.spice or bias_gen.spice has changed.
- **Plans** are stale if the objective they reference has been superseded.

### Log Pruning
- Superseded records are marked `status: "superseded"` with a reference to the new record, but never deleted
- The `active_*.json` index files always point to the current state
- Old records remain for audit trail and learning

### Cross-Referencing
Every record references its parent objective and plan. This enables:
- "Show me all verification results for OBJ-001"
- "What did the reviewer say about PLAN-003?"
- "When was the last time F1 was tested?"

---

## 11. IMPLEMENTATION NOTES

### How Skills Run in Practice
Each skill is a Claude skill (`.md` file in `.claude/skills/`) that can be invoked by name. When invoked, the skill:
1. Reads the relevant log files to understand current state
2. Performs its function
3. Writes its output to the appropriate log file
4. Returns a summary to the calling context

### Concurrency Model
In a multi-session setup:
- One session runs the main design loop
- Parallel sessions can run long simulations (ngspice frontend cache generation)
- The Verification Engineer can run regression tests in a background session
- The Design Reviewer operates on completed work products (no race condition with execution)

### Skill Invocation
Skills can be invoked:
- **Automatically** by the design loop (each step triggers the next skill)
- **Manually** by the user (`/objectives`, `/plan`, `/analog`, `/verify`, `/review`, `/integrate`, `/summary`)
- **By other skills** when consultation is needed (e.g., Verification calls Analog Specialist for failure analysis)

### Growing the Knowledge Base
The Analog Specialist's knowledge base starts with the entries above and grows as the project progresses. Sources for new entries:
- Simulation results that reveal new design rules
- Textbook principles needed for a specific design decision
- Published papers with relevant techniques
- Lessons learned from failed approaches

Every knowledge base entry is tagged with whether it has been verified by simulation on this specific process/technology, or is a general principle that needs process-specific validation.

---

## 12. EXPECTED BENEFITS

1. **No lost context:** Every decision, result, and concern is logged. A new session can read the logs and pick up where the last one left off.
2. **No undetected errors:** The Design Reviewer catches errors that propagate when a single engineer (or single Claude session) does everything.
3. **Optimal path:** The Architect/Planner always has the full picture (objectives + current state + specialist input) when choosing an approach.
4. **Measurable progress:** Every cycle produces quantitative results compared to quantitative targets. No "I think it's better" — it either passes the criteria or it doesn't.
5. **Reproducible:** Log files record exactly what was done, why, and what the results were. Any design decision can be traced back to its objective, plan, and verification.
6. **Portable:** The framework (minus project-specific knowledge) applies to any analog/mixed-signal IC project.

---

## APPENDIX: Project-Specific Quick Reference

### Current System State (as of 2026-11-10)
- **Frontend:** 8 features, hybrid mirror+diode loads, F1/F2 fixed (IC propagation + 55ms capture + early F2 measurement), F3-F8 mostly passing criteria
- **Classifier:** 8→64→5 MLP, 96.04% on digital features, crossbar agreement 99.65%
- **Integration:** Not yet combined. Voltage domain mismatch (0.9V→1.8V) solved by per-feature affine VCVS. Feature reorder mapping defined. Normalization gap identified.
- **Key blocker:** Running full feature cache (44 records × ~10 min each ≈ 7 hrs) for integration calibration

### File Quick Reference
| Block | Circuit Files | Test Scripts | Results |
|---|---|---|---|
| Frontend | `experiments/frontend_optimization/complete_frontend/*.spice` | `full_accuracy_test.py`, `integration_test.py` | `_cache/*.json` |
| Classifier | `experiments/Complete_imp/classifier_crossbar/*.spice` | `full_analog_mlp.py`, `crossbar_accuracy.py` | `*_results.json` |
| Integration | `experiments/integration/*.py` | `integrate_frontend_classifier.py` | `digital_verification_results.json` |

### Critical Numbers
| Parameter | Value | Source |
|---|---|---|
| VDD frontend | 0.9V | design constraint |
| VDD classifier | 1.8V | SKY130 ReRAM read voltage requirement |
| V_READ | 0.15V | crossbar read voltage |
| Frontend energy | 1.02 nJ/beat | measured (frontend-optimization-status memory) |
| IA gain | ×103 | Cin/Cfb = 10pF/0.098pF |
| EWMA alpha | 0.10 | 5pF/(5pF+45pF) charge sharing |
| SF settling tau | 3.88ms | 776MΩ × 5pF |
| Capture pulse | 55ms | 14×tau for 99.99% settling |
| Feature validation | ρ≥0.97, clip<1%, span≥225mV, d≥75% | feature-validation-criteria memory |
