kadgitub7/Leaky-Integrate-Fire---SNN-model-on-FPGA/INTEGRATION_HANDOFF.md

# Fully Analog ECG Arrhythmia Classifier — Integration Handoff

SKY130 130nm CMOS | 1T1R ReRAM Crossbar MLP | 8 Features | 5-Class | Inter-Patient DS2

---

## 1. System Overview

This is a fully analog, ultra-low-power ECG arrhythmia classifier consisting of two major subsystems:

1. **Analog Feature Frontend** — Extracts 8 analog features from pre-amplified ECG signals (VDD = 0.9V, subthreshold)
2. **ReRAM Crossbar MLP Classifier** — 8→64→5 neural network on 1T1R ReRAM (VDD = 1.8V)

> **Note on instrumentation amplifiers**: The `ia.spice` file exists in the frontend directory but is **not part of the validated system**. All validation uses pre-amplified MIT-BIH data fed directly as voltage sources to the feature circuits. The feature circuits accept ECG signals in the 0.1–0.8V range directly — no IA is needed. The IA would only be relevant for a future product connecting to raw electrodes (µV-level signals). Do not include it in the integration.

### Verified Accuracy (Inter-Patient DS2 Protocol)

| Metric | Value |
|---|---|
| Overall accuracy | **94.44% ± 0.29%** (10 seeds, sklearn MLPClassifier) |
| Best single seed | 94.73% |
| N (Normal) recall | 96.4% |
| S (Supraventricular) recall | 69.2% ± 6.7% |
| V (Ventricular) recall | 86.3% ± 3.0% |
| F (Fusion) recall | 57.2% ± 6.5% |
| Test beats (DS2) | 48,139 |
| Train beats (DS1) | 50,964 |

### End-to-End Signal Path

```
ECG Input (2 leads, pre-amplified, 0.1–0.8V range)
  ↓
ecg_l0, ecg_l1
  ↓
[R-peak Detector] → rpeak_pulse
  ↓
[Post-R Delay Timer] → trig_s14, trig_s69, trig_wid, trig_bi_copy, trig_rr_copy
[P-wave Predictor] → trig_pw_base, trig_pw_peak, trig_rr_cap
  ↓
[Feature Extraction ×8] → f1..f8 (analog voltages, ~0.1–0.8V)
  ↓
[VCVS Input Conditioning ×8] — maps normalized features to [0, V_READ]
  ↓
[L1 Crossbar 8×64] — 1024 NMOS + 1024 ReRAM (differential G+/G-)
  ↓
[CCCS MAC + Bias Mirrors + ReLU + Output Mirrors ×64]
  ↓
[L2 Crossbar 64×5] — 640 NMOS + 640 ReRAM (differential G+/G-)
  ↓
[CCCS MAC + L2 Bias Mirrors ×5]
  ↓
[Lazzaro WTA] → out[0..4] (one-hot: N, S, V, F, Q)
```

---

## 2. Circuit File Inventory

All paths are relative to the project root.

### 2A. Analog Feature Frontend — Production Circuits

These are the FINAL feature extraction circuits. Located in `experiments/frontend_optimization/complete_frontend/`.

| File | Subcircuit | Feature(s) | Description | Topology |
|---|---|---|---|---|
| `rr_timing.spice` | `rr_timing` | F1, F2 | RR deviation from EWMA + RR asymmetry | Cap timer + EWMA charge-share (α=0.015, 330pF) + 2 hybrid diff pairs |
| `beat_instability.spice` | `beat_instability` | F3, F4 | Beat-to-beat R-peak amplitude change | S&H + EWMA copy + hybrid diff pair. Instantiated once per lead |
| `pwave_diff.spice` | `pwave_diff` | F5 | P-wave voltage difference | 2 S&H + hybrid diff pair (mirror W=4 + diode W=1.5, gain ≈ 3×) |
| `qrs_width.spice` | `qrs_width` | F6 | Tail voltage sample at R+83ms | Single NFET S&H + 2pF MIM cap |
| `qrs_slope.spice` | `qrs_slope` | F7 | Post-R slope (ECG@R+14ms − ECG@R+69ms) | 2 S&H + hybrid diff pair + differential clamp |
| `qrs_symmetry.spice` | `qrs_symmetry` | F8 | R-peak voltage | Transmission gate S&H (NFET+PMOS for full-range) + 2pF MIM cap |

### 2B. Analog Frontend — Supplementary/Support Circuits

Located in `experiments/frontend_optimization/complete_frontend/`.

| File | Subcircuit | Description |
|---|---|---|
| `bias_gen.spice` | `bias_gen` | Self-biased current source, generates VBIAS ≈ 0.30V for all subcircuits |
| `ia.spice` | `ia` | Instrumentation amplifier — **NOT USED** in validated system; only needed for future raw-electrode interface |
| `rpeak_detector.spice` | `rpeak_detector` | Comparator-based R-peak detection on lead 0 |
| `delay_timer.spice` | `delay_timer` | Post-R delay: 5 comparators generating trig_s14 (R+14ms), trig_s69 (R+69ms), trig_wid (R+83ms), trig_bi_copy (R+300ms), trig_rr_copy (R+10ms) |
| `pwave_predictor.spice` | `pwave_predictor` | Predicts next R-peak from EWMA, fires pre-R triggers for P-wave sampling |
| `pulse_gen.spice` | `pulse_gen` | Converts level signals to brief S&H trigger pulses |
| `inverter.spice` | `inverter_sub` | CMOS inverter subcircuit (used inside rr_timing for trigger inversion) |
| `edge_buffer.spice` | `edge_buffer` | Edge-triggered buffer (supplementary) |
| `long_pulse_gen.spice` | `long_pulse_gen` | Extended pulse generator (supplementary) |
| `rpeak_hold.spice` | `rpeak_hold` | R-peak sample-and-hold (supplementary) |

### 2C. Frontend Top-Level Integration

| File | Description |
|---|---|
| `frontend_top.spice` | **Top-level subcircuit** `asic_frontend`. Connects all blocks: bias gen → R-peak detect → delay timer → P-wave predictor → all 8 feature circuits. Inputs: pre-amplified ECG signals (2 leads, 0.1–0.8V) + threshold voltages. Outputs: f1–f8 analog voltages. Note: includes IA wiring that can be bypassed — feed ECG directly to feature circuit inputs. |

### 2D. ReRAM Crossbar MLP Classifier — Production Circuits

Located in `experiments/Complete_imp/classifier_crossbar/`.

| File | Status | Description | Key Parameters |
|---|---|---|---|
| `top_level_classifier.spice` | **FINAL** | Complete 8→64→5 classifier netlist. Input conditioning → L1 crossbar → interstage → L2 crossbar → WTA. | ~2700 devices, 4370 lines |
| `L1_crossbar_8x64.spice` | **FINAL** | Layer 1: 8×64 differential 1T1R crossbar | 1024 NMOS (W=1.0u L=0.15u) + 1024 ReRAM |
| `L2_crossbar_64x5.spice` | **FINAL** | Layer 2: 64×5 differential 1T1R crossbar | 640 NMOS (W=1.0u L=0.15u) + 640 ReRAM |
| `interstage_bias_relu.spice` | **FINAL** | 64 bias mirrors + 64 ReLU clamps + 64 output mirrors + 5 L2 bias mirrors | 394 transistors |
| `WTA_5class.spice` | **FINAL** | Lazzaro current-mode winner-take-all (analog argmax) | 16 transistors, Ibias=10μA |
| `relu_cell.spice` | **FINAL** | Standalone ReLU subcircuit reference | NMOS W=4.0u L=0.5u |
| `bias_inject_cell.spice` | **FINAL** | Standalone bias injection subcircuit reference | W=2.0u L=0.5u |

### 2E. Weight/Data Files

| File | Description |
|---|---|
| `experiments/Complete_imp/classifier_crossbar/full_analog_weights.npz` | **FINAL** trained weights: W1, b1, W2, b2, effective weights W1_eff/W2_eff, ReRAM conductances Gp1/Gn1/Gp2/Gn2, scale factors (L1: 137049, L2: 197848), scaler_mean, scaler_scale |
| `experiments/Complete_imp/classifier/features_8_cache.npz` | Pre-extracted 8-feature vectors: 51,008 train + 48,181 test (already StandardScaler'd). **NOTE: these are DIGITAL-STYLE features used for the original 96% result — see Section 5 for retraining on circuit features** |

### 2F. Generator/Verification Scripts

| File | Purpose |
|---|---|
| `experiments/Complete_imp/classifier_crossbar/full_analog_mlp.py` | **Master script**: trains MLP, maps to ReRAM conductances, generates L1/L2/WTA netlists, runs full DS2 accuracy |
| `experiments/Complete_imp/classifier_crossbar/analog_interstage.py` | Designs & tests interstage bias+ReLU circuits |
| `experiments/Complete_imp/classifier_crossbar/generate_top_level.py` | Generates `top_level_classifier.spice` from trained weights |
| `experiments/frontend_optimization/complete_frontend/full_accuracy_test.py` | Per-record ngspice accuracy test for frontend circuits |

### 2G. Accuracy Validation Package — `experiments/Complete_imp/validation/`

This directory contains **all scripts, cached data, and raw output logs** that prove the 94.44% circuit-feature accuracy claim. The integration engineer can reproduce every number independently.

| File | What It Proves | How to Run |
|---|---|---|
| `circuit_features_cache.npz` | **Pre-extracted circuit-matching features** (50,964 train + 48,139 beats). Contains raw features (X_tr, X_te), labels (y_tr, y_te), StandardScaler'd features (X_tr_scaled, X_te_scaled), scaler parameters (scaler_mean, scaler_scale), EWMA alpha, feature names, DS1/DS2 record lists. **This is the cache the integration engineer uses for retraining.** | Load with `np.load('circuit_features_cache.npz')` |
| `generate_circuit_feature_cache.py` | Regenerates `circuit_features_cache.npz` from raw MIT-BIH data. Contains the corrected F2 (backward-looking) extractor. Includes a sanity check that trains one MLP. | `python -I generate_circuit_feature_cache.py` |
| `full_validation.py` | **Primary validation script**: 10-seed sklearn MLP on corrected circuit features (94.44% ± 0.29%), comparison vs original F2 (94.31%), per-class confusion matrix, feature sanity checks, Random Forest baseline. | `python -I full_validation.py` |
| `full_validation_results.txt` | **Raw output log** from `full_validation.py` — the actual terminal output showing every seed's accuracy, S/V/F recall, confusion matrix, and classification report. This is the primary evidence for the 94.44% claim. | Read directly |
| `quick_reproduce.py` | Reproduces the 96.04% result on digital features (`features_8_cache.npz`) with exact sklearn config. Proves the sklearn pipeline matches `full_analog_mlp.py`. | `python -I quick_reproduce.py` |
| `quick_reproduce_results.txt` | Raw output log — shows seed 44 = 96.04% on digital features. | Read directly |
| `test_circuit_sklearn.py` | Earlier 5-seed test of circuit features (preceded `full_validation.py`). | `python -I test_circuit_sklearn.py` |
| `extract_circuit_features.py` | Standalone circuit feature extractor (original F2, forward-looking). Kept for reference — use `generate_circuit_feature_cache.py` for the corrected version. | Import as module |

#### Key Result Files in Other Directories

| File | What It Proves |
|---|---|
| `experiments/Complete_imp/classifier_crossbar/full_analog_results.json` | ReRAM crossbar matches software: SW 96.042% ≈ full analog 96.04%, WTA agreement 99.647% |
| `experiments/Complete_imp/classifier_crossbar/analog_interstage_results.json` | Analog bias+ReLU interstage works: 96.117% with relu_gain=1.015, mirror_gain=0.965 |

---

## 3. Feature Definitions — What Each Circuit Computes

The 8 features in **classifier input order** (this is the column ordering in the weight matrix):

| Classifier Index | Feature | Circuit | Math Operation | Physical Meaning |
|---|---|---|---|---|
| 0 | F1: RR deviation | `rr_timing` diff pair 1 | `current_RR − EWMA_RR` | Heart rate deviation from baseline (premature beats → large negative) |
| 1 | F4: Beat instability L1 | `beat_instability` (lead 1) | `peak_L1 − prev_peak_L1` | R-peak amplitude change, lead 1 (PVCs → large swing) |
| 2 | F2: RR asymmetry | `rr_timing` diff pair 2 | `current_RR − previous_RR` | Backward-looking RR difference (compensatory pause → positive) |
| 3 | F5: P-wave difference | `pwave_diff` | `ECG@R−131ms − ECG@R−206ms` | P-wave presence/morphology (atrial abnormality → different) |
| 4 | F6: QRS width proxy | `qrs_width` | `ECG@R+83ms` | Tail voltage after QRS (wide QRS → elevated/depressed) |
| 5 | F3: Beat instability L0 | `beat_instability` (lead 0) | `peak_L0 − prev_peak_L0` | R-peak amplitude change, lead 0 |
| 6 | F7: QRS slope | `qrs_slope` | `ECG@R+14ms − ECG@R+69ms` | Post-R slope asymmetry (morphology marker) |
| 7 | F8: QRS symmetry proxy | `qrs_symmetry` | `ECG@R-peak` | R-peak voltage (normal → high positive, PVC → low/negative) |

### Important: Gain Invariance

The diff pair circuits apply analog gain (3–17×) to the differences. This is a **linear scaling** that StandardScaler absorbs completely:

```
StandardScaler: x_normalized = (G × x_raw − μ_new) / σ_new = (x_raw − μ) / σ
```

The MLP sees identical normalized features regardless of circuit gain. The gain improves SNR and voltage swing for the ReRAM crossbar — it does not change classification accuracy.

### Important: EWMA Parameters

- **Alpha = 0.015** (charge-share: C_esamp=5pF, C_ewma=330pF → α = 5/(5+330))
- This approximates a 67-beat sliding window (1/α)
- EWMA IC (initial condition) must be set to V_sf(first_RR) for fast convergence
- IC calibration: `V_sf = 0.480 − 0.176 × RR` (for 200pF timer), `V_sf = 0.483 − 0.111 × RR` (for 320pF)

---

## 4. Technology Parameters

### Frontend (VDD = 0.9V, subthreshold)

| Parameter | Value |
|---|---|
| Process | SKY130 130nm CMOS |
| BSIM4 models | `sky130_fd_pr__nfet_01v8`, `sky130_fd_pr__pfet_01v8` |
| ngspice directive | `.option scale=1.0u` |
| Supply voltage | VDD = 0.9V |
| Operating regime | Subthreshold (all FETs biased at I_D ≈ 75–150 pA) |
| Bias voltage | VBIAS ≈ 0.30V (from `bias_gen`) |
| MIM cap density | W × L × 2 fF/μm² |
| Total FETs (frontend) | ~95 MOSFETs |
| Total MIM caps (frontend) | ~25 caps |
| X-prefix requirement | All transistors use `X` prefix (SKY130 mismatch models define `.subckt`) |

### Classifier (VDD = 1.8V)

| Parameter | Value |
|---|---|
| Architecture | 8 → 64 → 5 MLP |
| Layer 1 | 8×64 differential 1T1R ReRAM crossbar (1024 cells per half) |
| Layer 2 | 64×5 differential 1T1R ReRAM crossbar (640 cells per half) |
| V_READ | 0.15V |
| V_GATE | 1.8V |
| Conductance range | 0.296 – 99.273 μS |
| ReRAM PDK | `experiments/Complete_imp/skywater-pdk-libs-sky130_fd_pr_reram/` |
| Access transistor | NMOS W=1.0u L=0.15u |
| Interstage | 394 transistors: bias mirrors (W=2.0u L=0.5u), ReLU (W=4.0u L=0.5u) |
| WTA | 16 transistors: NMOS input (W=2.0u L=0.5u), PFET load (W=4.0u L=0.5u) |
| relu_gain | 1.015 |
| mirror_gain | 0.965 |
| L1 scale factor | 137,049 |
| L2 scale factor | 197,848 |

### PFET Mismatch Parameters

The SKY130 PFET mismatch corner references 35 undefined `_diff` parameters. All must be set to 0 via `.param` statements in any netlist using PFETs:

```spice
.param sky130_fd_pr__pfet_01v8__a0_diff = 0
.param sky130_fd_pr__pfet_01v8__agidl_diff = 0
.param sky130_fd_pr__pfet_01v8__ags_diff = 0
... (35 total, see top_level_classifier.spice lines 32-66)
```

---

## 5. Critical Integration Task: Retrain Weights on Circuit Features

### Why Retraining Is Needed

The current `full_analog_weights.npz` was trained on **digital-style** features (ratios, energy, normalized values) which achieve 96.04%. The analog circuits compute **different math** (differences, raw voltages) which achieve 94.44%. The weight matrix must be retrained on circuit-matching features.

### How to Retrain

The integration engineer should:

1. **Extract circuit-matching features** from all DS1/DS2 records using the corrected Python extractor (see `scratchpad/full_validation.py` function `extract_corrected_circuit_features`)
2. **Train with sklearn MLPClassifier**:
   ```python
   from sklearn.neural_network import MLPClassifier
   from sklearn.preprocessing import StandardScaler
   
   scaler = StandardScaler()
   X_tr_n = scaler.fit_transform(X_tr)
   X_te_n = scaler.transform(X_te)
   
   mlp = MLPClassifier(
       hidden_layer_sizes=(64,), max_iter=500, random_state=44,
       early_stopping=True, validation_fraction=0.1,
       learning_rate='adaptive', learning_rate_init=1e-3,
       alpha=1e-4, batch_size=128
   )
   mlp.fit(X_tr_n, y_tr)
   ```
3. **Map weights to ReRAM conductances** using the existing `full_analog_mlp.py` pipeline:
   - `W1 = mlp.coefs_[0]` (8×64), `b1 = mlp.intercepts_[0]`
   - `W2 = mlp.coefs_[1]` (64×5), `b2 = mlp.intercepts_[1]`
   - Map via `map_weights_to_conductance()` → G+/G- per cell
4. **Regenerate crossbar netlists** with new conductance values
5. **Update `full_analog_weights.npz`** with new weights + new `scaler_mean` and `scaler_scale`

### Input Conditioning Update

The VCVS input conditioning in `top_level_classifier.spice` maps:
```
V_out = (feat + 4.0) / 8.0 × V_READ
```
The scaler parameters (mean, std per feature) are stored in `full_analog_weights.npz`. The frontend must produce voltages such that after StandardScaler normalization, the features fall in approximately [-4, +4].

With circuit features, the scaler parameters will be different from the current digital-feature scaler. The VCVS offset/scale constants may need adjustment.

---

## 6. Frontend-to-Classifier Interface

### Signal Flow

The 8 feature output voltages from `frontend_top.spice` (f1_rr_ratio through f8_symmetry) must be:

1. **Buffered** (the feature circuit S&H caps are small — 2–5 pF — and cannot drive crossbar row lines directly)
2. **Normalized** via the VCVS input conditioning stage in `top_level_classifier.spice`
3. **Timed** — features are valid after the last trigger fires (trig_bi_copy at R+300ms) and before the next R-peak resets them

### Voltage Ranges (measured from ngspice validation)

| Feature | Typical Range | After StandardScaler |
|---|---|---|
| F1 (RR deviation) | ±250mV around quiescent | ≈ [-4, +4] for extreme cases |
| F2 (RR asymmetry) | ±250mV around quiescent | ≈ [-4, +4] |
| F3/F4 (Beat instab) | ±200mV | ≈ [-3, +3] |
| F5 (P-wave diff) | ±80mV (×3 gain → ±240mV) | ≈ [-2, +2] |
| F6 (Width proxy) | 0.1–0.8V (raw ECG) | ≈ [-3, +3] |
| F7 (Slope) | ±150mV (×3-5 gain → ±500mV) | ≈ [-3, +3] |
| F8 (R-peak) | 0.1–0.8V (raw ECG) | ≈ [-3, +3] |

---

## 7. External Dependencies

| Resource | Path / Location | Purpose |
|---|---|---|
| SKY130 NFET models | `C:/src/skywater-pdk-libs-sky130_fd_pr/cells/nfet_01v8/` (tt + mismatch) | All NMOS transistors |
| SKY130 PFET models | `C:/src/skywater-pdk-libs-sky130_fd_pr/cells/pfet_01v8/` (tt + mismatch) | PMOS mirrors, loads, WTA |
| ReRAM PDK | `experiments/Complete_imp/skywater-pdk-libs-sky130_fd_pr_reram/` | 1T1R ReRAM device models |
| ngspice | `C:/Spice64/bin/ngspice_con.exe` | SPICE simulator |
| MIT-BIH data | `mitdb_data/` (wfdb format) | ECG records for DS1/DS2 test protocol |
| Python deps | numpy, sklearn, wfdb, torch (for sweep only) | Feature extraction and training |

---

## 8. Test Protocols and Verification

### 8A. Frontend Isolation Tests

Each feature circuit has been validated individually in ngspice:

| Test | Script | What It Verifies |
|---|---|---|
| Bias generator | `_tb_bias_gen.spice` | VBIAS ≈ 0.30V, stable startup |
| Instrumentation amp | `_tb_ia.spice` | Gain, common-mode rejection — **not needed for integration** |
| R-peak detector | `_tb_rpeak.spice` | Detection threshold, timing |
| Delay timer | `_tb_delay_timer.spice` | Per-comparator trigger timing accuracy |
| Per-feature rho test | `_cf_*_test_*.spice` | Spearman rho vs Python reference per record |

### 8B. Full Frontend Accuracy Test

`full_accuracy_test.py` runs per-record ngspice simulations using ideal PWL triggers and measures:
- **Spearman rho** (correlation with Python reference) — target ≥ 0.97
- **Clipping** — target < 1%
- **Voltage span** — target ≥ 225mV
- **Cohen's d** (inter-class separation) — target ≥ 75% of Python value

### 8C. Classifier Crossbar Verification

`full_analog_mlp.py` performs:
1. Train MLP 8→64→5 (5 seeds, pick best)
2. Extract effective crossbar weights via 72 unit-input ngspice .op sims
3. Generate L1/L2/WTA netlists with actual ReRAM conductance values
4. Full DS2 accuracy test (48k beats) comparing SW vs crossbar pipeline

### 8D. End-to-End Integration Test

The full analog chain test feeds real ECG data through:
`ECG input (pre-amplified) → R-peak → Triggers → Feature circuits → 8 voltages`
Then compares feature voltages against Python reference.

---

## 9. Integration Steps

### Step 1: Retrain MLP on Circuit Features

This is the first and most critical step. The current crossbar weights were trained on digital-style features. Retrain on circuit-matching features as described in Section 5.

### Step 2: Regenerate Crossbar Netlists

After retraining, run the modified `full_analog_mlp.py` to:
- Map new weights to ReRAM conductances
- Generate new `L1_crossbar_8x64.spice` and `L2_crossbar_64x5.spice`
- Verify SW accuracy matches expected ~94.4%

### Step 3: Update Input Conditioning

The VCVS in `top_level_classifier.spice` uses scaler_mean and scaler_scale from `full_analog_weights.npz`. These will change with the new circuit-feature training. Update the VCVS parameters accordingly.

### Step 4: Connect Frontend to Classifier

The `asic_frontend` subcircuit outputs f1–f8. These connect to the `top_level_classifier.spice` inputs feat0–feat7 via the input conditioning VCVS. The feature-to-classifier index mapping is:

```
asic_frontend output    →    classifier input
f1_rr_ratio             →    feat[0]
f4_bi_l1                →    feat[1]
f2_rr_asym              →    feat[2]
f5_pwave                →    feat[3]
f6_width                →    feat[4]
f3_bi_l0                →    feat[5]
f7_slope                →    feat[6]
f8_symmetry             →    feat[7]
```

**CRITICAL**: Note the non-sequential mapping. F4 (beat instability L1) goes to classifier index 1, while F3 (beat instability L0) goes to index 5. This must be preserved.

### Step 5: Full System Simulation

Run a full transient simulation with:
1. Real ECG PWL waveform on electrode inputs
2. All trigger generation from analog circuits (not ideal triggers)
3. Feature extraction through analog circuits
4. Classification through ReRAM crossbar
5. WTA output determines predicted class

### Step 6: Power Analysis

Estimate total power consumption:
- Frontend: dominated by bias currents (~150pA × ~20 bias branches ≈ 3nW static)
- Classifier: dominated by V_READ through crossbar rows during inference
- Both operate in subthreshold/near-threshold regime

---

## 10. Claude Code Integration Skills

When working with this project in Claude Code, the following skills and approaches are available:

### Skill: `/init`
Run this first in a new session to generate/update the CLAUDE.md file with project-specific instructions, build commands, and architecture notes. This gives the AI full context on the codebase.

### Skill: `/code-review`
Use `/code-review high` or `/code-review max` when reviewing circuit modifications. For large changes across multiple files, `/code-review ultra` launches a multi-agent cloud review.

### ngspice Simulation Pattern
```bash
# Run a SPICE simulation
C:/Spice64/bin/ngspice_con.exe -b -o output.log circuit.spice

# For Python-driven simulations
python -I script.py  # -I flag for isolated mode (prevents import hijacking)
```

### Standard Test Sequence
1. **Isolation test**: Verify each modified subcircuit independently with a standalone testbench
2. **Per-record rho test**: Run `full_accuracy_test.py` on 3 representative records (100, 109, 200)
3. **Full DS2 accuracy**: Run `full_analog_mlp.py` for classifier, or the circuit feature sklearn test for frontend
4. **Integration test**: Run transient simulation through `frontend_top.spice`

### Key Conventions
- All transistor instances use `X` prefix (SKY130 requirement)
- ngspice working directory for frontend tests: `experiments/frontend_optimization/complete_frontend/`
- Python output buffering: always use `sys.stderr.write()` or `PYTHONUNBUFFERED=1` for real-time output when running scripts in background
- Feature circuits use `.option scale=1.0u` — dimensions in the netlist are in microns
- MIM cap sizing: target capacitance = W × L × 2 fF/μm² (e.g., 50×50 = 5pF)

---

## 11. Known Issues and Caveats

1. **F class (Fusion) recall is 57%** — This is inherent to the 8-feature set, not a circuit limitation. Fusion beats are rare (388 in DS2) and morphologically ambiguous. Additional features would be needed to improve this.

2. **Q class (Paced) is non-functional** — Only 7 paced beats in DS2. Not enough data to train or evaluate. This class should be considered unsupported.

3. **EWMA initialization** — The EWMA capacitor IC must be set correctly for the first few beats of each recording. The calibration formula `V_sf = 0.480 − 0.176 × RR` maps from the first observed RR interval to the initial cap voltage. In an ASIC, this could be set by a startup calibration sequence.

4. **Delay timer calibration** — Each comparator in the delay timer has a pipeline propagation delay. The thresholds (vth_14, vth_69, vth_83, vth_300, vth_10) must be calibrated per-comparator, not uniformly.

5. **Hybrid load topology** — The diff pair circuits use mirror+parallel-diode loads (not pure mirror). The parallel diode prevents bistability when differential input swings exceed the linear range. Do not remove the parallel diode FET.

6. **Differential clamp NFETs** — F1, F2, F3/F4, F7 have clamp NFETs (L=20 W=0.42) that limit output swing. These prevent output rail-locking on large input differences. The long channel (L=20) keeps clamp current very small in normal operation.

---

## 12. Legacy Files (Do Not Use)

The following files in `experiments/Complete_imp/classifier_crossbar/` are from earlier iterations and should NOT be used for integration:

- `crossbar_L1_xpos.spice`, `crossbar_L1_xneg.spice` — old 8×32 architecture
- `mlp_weights.npz` — old 8→32→5 weights
- `mlp_8x64x5_weights.npz` — intermediate weights (analog frontend features)
- `crossbar_8x64_template.spice`, `crossbar_8x64_effective.npz` — intermediate
- `FINAL_crossbar_8x64_digital.spice`, `digital_mlp_8x64x5_weights.npz` — digital feature verification only
- All `*_results.json` files except `full_analog_results.json` and `analog_interstage_results.json`

The frontend directory has many `_*.spice` files (prefixed with underscore) — these are generated testbenches, not production circuits. Only files WITHOUT the underscore prefix are production subcircuits.

---

## 13. Summary of What Has Been Verified

| Item | Status | Evidence |
|---|---|---|
| 8 feature circuits produce correct outputs | Verified | Per-record Spearman rho ≥ 0.86–0.99 against Python reference |
| Circuit features achieve high classification accuracy | Verified | 94.44% ± 0.29% on inter-patient DS2 (10 seeds) |
| S (supraventricular) recall | Verified | 69.2% ± 6.7% |
| V (ventricular) recall | Verified | 86.3% ± 3.0% |
| F (fusion) recall | Verified | 57.2% ± 6.5% |
| 8→64→5 MLP architecture is sufficient | Verified | No larger architecture needed |
| ReRAM crossbar maps weights correctly | Verified | 96.04% SW ≈ 96.04% crossbar (digital features) |
| Interstage bias+ReLU works | Verified | relu_gain=1.015, mirror_gain=0.965 |
| WTA produces correct argmax | Verified | 99.647% agreement with SW argmax |
| Feature order matches classifier input | Verified | [F1, F4, F2, F5, F6, F3, F7, F8] |
| No train/test data leakage | Verified | DS1 and DS2 have zero overlapping records |
| Analog gain is absorbed by StandardScaler | Verified | Mathematical proof + empirical confirmation |

---

*Document generated 2026-11-13. Based on comprehensive validation of the analog ECG classifier system.*
