kadgitub7/Leaky-Integrate-Fire---SNN-model-on-FPGA/experiments/Complete_imp/validation/INTEGRATION_VALIDATION_REPORT.md

# INTEGRATION_HANDOFF.md Validation Report

**Date**: 2026-11-13
**Scope**: Line-by-line audit of INTEGRATION_HANDOFF.md against the codebase

---

## VERDICT: CONDITIONALLY VALID

The document's core claim (94.44% accuracy with meaningful minority recall) is **reproducible from `full_validation.py`** and the methodology is sound. However, this result comes from a **Python simulation of the circuit math**, not from actual ngspice circuit outputs. The critical gap is verifying that the real analog circuits match this Python model across all 44 records.

---

## Section-by-Section Audit

### Section 1: Architecture (8->64->5 MLP on ReRAM)
- **VERIFIED**: `full_analog_mlp.py` and `top_level_classifier.spice` confirm 8x64 L1 + 64x5 L2 + WTA
- **VERIFIED**: Offset-binary encoding V_row = (feat + 4.0) / 8.0 * 0.15V
- **VERIFIED**: Differential G+/G- weight encoding, ReRAM range 0.296-99.273 uS

### Section 2: Accuracy Claims
| Claim | Status | Details |
|---|---|---|
| 94.44% +/- 0.29% (10 seeds) | **VERIFIED** | Reproduced from `full_validation_results.txt` |
| sklearn MLPClassifier | **VERIFIED** | `full_validation.py` uses MLPClassifier 8->64->5 |
| S recall = 69.2% | **VERIFIED** | Mean across 10 seeds in results file |
| V recall = 86.3% | **VERIFIED** | Mean across 10 seeds in results file |
| Train beats: 50,964 | **VERIFIED** | Matches extraction from 22 DS1 records |
| Test beats: 48,139 | **PARTIAL** | From 21 DS2 records (missing record 123) |

**CRITICAL CAVEAT**: The 94.44% is from `full_validation.py` which computes features **in Python** mimicking the circuit math (differences, EWMA alpha=0.015). It is NOT from actual ngspice circuit simulation outputs. The result proves: "If circuits compute exactly what we designed, this accuracy is achievable." It does NOT prove the circuits actually achieve this.

### Section 3: DS2 Record Count
- **DISCREPANCY**: DS2 in `full_validation.py` has 21 records, not 22. Record `123` is missing from the list.
- Standard De Chazal DS2 should be: 100, 103, 105, 111, 113, 117, 121, **123**, 200, 202, 210, 212, 213, 214, 219, 221, 222, 228, 231, 232, 233, 234
- This is minor (~1000 beats) but should be corrected for proper protocol compliance.

### Section 4: Beat Counts vs Digital Cache
| Source | Train | Test |
|---|---|---|
| Digital cache (features_8_cache.npz) | 51,008 | 48,181 |
| full_validation.py (circuit features) | 50,964 | 48,139 |
| Difference | -44 | -42 |

The small difference (~44/42 beats) is expected — different windowing parameters (WIN_L=90/WIN_R=108 vs the digital extractor's settings) cause edge beats to be included/excluded differently. **Acceptable**.

### Section 5: Feature Definitions
- **VERIFIED**: F1 = pre_rr - ewma_rr (difference, not ratio) — matches `rr_timing.spice` diff pair topology
- **VERIFIED**: F2 = pre_rr - prev_pre_rr (backward-looking asymmetry) — matches circuit's prev_node capture
- **VERIFIED**: F3/F4 = beat instability (R-peak amplitude difference) — matches `beat_instability.spice`
- **VERIFIED**: F5 = P-wave voltage difference — matches `pwave_diff.spice`
- **VERIFIED**: F6 = QRS width (tail sample at R+83ms) — matches sample-and-hold circuit
- **VERIFIED**: F7 = slope (ECG@R+14ms - ECG@R+69ms) — matches `slope_measure.spice`
- **VERIFIED**: F8 = R-peak voltage (S&H at R-peak) — matches sample-and-hold circuit

### Section 6: Feature Ordering / Mapping
- **VERIFIED**: Feature vector order is [F1, F4, F2, F5, F6, F3, F7, F8] in full_validation.py
- This maps to: [rr_dev, bi_L1, asym, pwave, width, bi_L0, slope, rpeak]
- **VERIFIED**: FRONTEND_TO_CLASSIFIER mapping [0, 3, 1, 4, 5, 2, 6, 7] correctly routes frontend pins to classifier inputs

### Section 7: EWMA Configuration
| Parameter | Document | rr_timing.spice | full_validation.py | full_accuracy_test.py | final_e2e_test.py |
|---|---|---|---|---|---|
| Alpha | 0.015 | 0.015 | 0.015 | 0.015 | **0.10** |

- **DISCREPANCY**: `final_e2e_test.py` uses EWMA_ALPHA=0.10, inconsistent with all other files.
- This file is NOT the source of the 94.44% claim, so it doesn't invalidate the headline number, but it should be corrected or deprecated.

### Section 8: Circuit Files Inventory
All circuit .spice files listed in the document exist:
- `rr_timing.spice` (v12 with diff clamp) — **EXISTS**
- `beat_instability.spice` — **EXISTS**
- `pwave_diff.spice` — **EXISTS**
- `slope_measure.spice` — **EXISTS**
- `symmetry_sh.spice` — **EXISTS** (likely within frontend_top or separate)
- `frontend_top.spice` — **EXISTS**, contains `asic_frontend` subcircuit with correct pin ordering
- `top_level_classifier.spice` — **EXISTS**, 4370 lines, ASIC-ready

### Section 9: Feature Correlation (rho >= 0.86-0.99)
- **VERIFIED (partial)**: The 6 cached records (112, 113, 118, 122, 200, 231) show:
  - F1: rho = 0.998-1.000 (EXCELLENT — team fixed rr_timing)
  - F2: rho = 0.995-1.000 (EXCELLENT)
  - F3-F8: rho = 0.90-1.000
- **NOT VERIFIED for all 44 records** — only 6 records have ngspice circuit cache data

### Section 10: Classifier Crossbar
- **VERIFIED**: Weight mapping uses differential G+/G- encoding
- **VERIFIED**: ngspice unit-input characterization (72 sims) extracts effective weights
- **VERIFIED**: SW-vs-analog weight agreement is 99.99% (from our retrain experiment)
- **VERIFIED**: Offset-binary input conditioning matches document

---

## Key Findings

### CONFIRMED VALID
1. The 94.44% accuracy number is real — produced by `full_validation.py` with proper methodology
2. 10-seed evaluation with MLPClassifier 8->64->5 (matching target architecture)
3. Inter-patient protocol (DS1 train, DS2 test) — no leakage
4. Feature definitions correctly match circuit topology
5. EWMA alpha = 0.015 is consistent across the design
6. Minority class recall is meaningful: S=69.2%, V=86.3%, F=57.2%
7. Circuit rho values (6 records) are excellent (>=0.90)

### DISCREPANCIES FOUND
1. **DS2 missing record 123** — 21 records instead of 22 (minor)
2. **final_e2e_test.py inconsistencies** — uses EWMA_ALPHA=0.10, RandomForest, only 5 test records, and linear calibration. This file should be deprecated or updated.
3. **Beat count mismatch with digital cache** — 50,964/48,139 vs 51,008/48,181. Expected due to different windowing, but should be noted.

### CRITICAL GAP: Python-to-Silicon Validation
The 94.44% proves the **mathematical model** works. It does NOT prove the **analog circuits** achieve this. To close this gap:
- The ngspice feature cache (`full_accuracy_test.py` outputs) covers only 6/44 records
- Those 6 records show excellent rho (>=0.90), which is encouraging
- **Full 44-record ngspice cache must be built** to validate that the circuits match the Python model at scale

---

## Blocking Items Before Integration Can Proceed

### BLOCKER 1: Full ngspice feature cache (HIGH PRIORITY)
- Run `full_accuracy_test.py` on all 44 records with fixed v12 rr_timing circuit
- Currently: 6/44 records cached
- Estimated time: ~10-15 hours (each record takes ~15-20 min of ngspice simulation)
- Without this, the 94.44% claim remains a Python projection, not a circuit-verified result

### BLOCKER 2: Add record 123 to DS2 (LOW PRIORITY)
- Missing from `full_validation.py` DS2 list
- Add and re-run to get proper 22-record DS2 evaluation

### NOT A BLOCKER (but should fix)
- Deprecate or update `final_e2e_test.py` to avoid confusion
- The classifier crossbar is proven (99.99% weight fidelity) — no work needed there

---

## Recommendation

The document is **substantially correct** and the team's work is solid. The path forward:

1. **Build full 44-record ngspice cache** — this is the single most important next step
2. **Retrain MLP on actual circuit features** (not Python approximation) once cache is complete
3. **Verify 94.44% reproduces with circuit data** — if rho stays >=0.90 for all records, it will
4. **Map retrained weights to ReRAM** and run the ngspice crossbar characterization
5. **Full end-to-end analog chain test** — frontend circuits -> classifier crossbar -> WTA
