kadgitub7/Leaky-Integrate-Fire---SNN-model-on-FPGA/experiments/frontend_optimization/complete_frontend_v9b/_test_output.txt

============================================================
FULL ANALOG CHAIN INTEGRATION TEST
All timing from analog circuits, no PWL triggers
============================================================

R-peak voltages: max=0.3619V min=0.3427V threshold=0.3309V
Record 100: 40 beats, gain=0.0589
Running timer calibration simulation...
Calibration completed in 11.3s
  RR timer precharge & discharge:
     precharge: net=0.89999V  sf=0.48756V  Vgs_sf=0.4124V
           001: net=0.89984V  sf=0.48744V  Vgs_sf=0.4124V
           005: net=0.89939V  sf=0.48707V  Vgs_sf=0.4123V
           010: net=0.89884V  sf=0.48662V  Vgs_sf=0.4122V
           050: net=0.89440V  sf=0.48300V  Vgs_sf=0.4114V
           200: net=0.87776V  sf=0.46943V  Vgs_sf=0.4083V
           400: net=0.85562V  sf=0.45139V  Vgs_sf=0.4042V
           600: net=0.83352V  sf=0.43342V  Vgs_sf=0.4001V
  Vbias: 0.2915V
  Delay timer SF curve (ms from rpeak drop):
       1ms: 0.48926V
       2ms: 0.48885V
       3ms: 0.48844V
       4ms: 0.48800V
       5ms: 0.48760V
      10ms: 0.48550V
      15ms: 0.48338V
      20ms: 0.48129V
      50ms: 0.46874V
     100ms: 0.44790V
     200ms: 0.40649V
     300ms: 0.36547V
     400ms: 0.32487V
     500ms: 0.28468V
     600ms: 0.24491V
     700ms: 0.20555V
     800ms: 0.16667V
  Fast timer SF curve:
       1ms: 0.47882V
       2ms: 0.47046V
       3ms: 0.46212V
       5ms: 0.44548V
      10ms: 0.40415V
      20ms: 0.32273V
  RR timer SF curve:
       1ms: 0.48744V
       5ms: 0.48707V
      10ms: 0.48662V
      50ms: 0.48300V
     100ms: 0.47848V
     200ms: 0.46943V
     400ms: 0.45139V
     600ms: 0.43342V
Avg RR: 0.813s, Sim time: 34.2s
Calibrated thresholds:
  vth_14=0.38379 (FAST timer) vth_28=0.47962 vth_69=0.46249 vth_300=0.36711
  vth_10=0.41655 (fast timer)
  ewma_init=0.41885 (RR timer SF at capture time)
  Pwave thresholds: adaptive per-beat PWL (from EWMA-predicted RR)
  Per-beat pwave thresholds (beat 0): base=0.24141 peak=0.21386 rrcap=0.18226
  Per-beat pwave thresholds (beat 5): base=0.24507 peak=0.21752 rrcap=0.18587
Running ngspice simulation (40 beats, ~34s sim time)...
Simulation completed in 106.1s

Extracted 848 measurements

=== DIAGNOSTICS ===
  Vbias (bias_gen): 0.2915V (target: ~0.300V)
  Beat 0: ecg=0.3554V stg1=0.1502V rpk=0.899975V
  Beat 1: ecg=0.3522V stg1=0.1527V rpk=0.899949V
  Beat 2: ecg=0.3477V stg1=0.1543V rpk=0.899945V
  Beat 3: ecg=0.3483V stg1=0.1558V rpk=0.899945V
  Beat 4: ecg=0.3522V stg1=0.1526V rpk=0.899951V
  R-peaks detected: 40/40

  rpeak_raw timeline (beat 2):
    R  -5ms: -0.0000V (LOW)
    R  -4ms: -0.0000V (LOW)
    R  -3ms: -0.0000V (LOW)
    R  -2ms: 0.0000V (LOW)
    R  -1ms: 0.4337V (LOW)
    R  +0ms: 0.8999V (HIGH)
    R  +1ms: 0.8999V (HIGH)
    R  +2ms: 0.8999V (HIGH)
    R  +3ms: 0.8999V (HIGH)
    R  +4ms: 0.9000V (HIGH)
    R  +5ms: 0.9000V (HIGH)
    R  +6ms: 0.9000V (HIGH)
    R  +7ms: 0.8999V (HIGH)
    R  +8ms: 0.8994V (HIGH)
    R  +9ms: 0.4788V (LOW)
    R +10ms: 0.0001V (LOW)
    R +11ms: -0.0000V (LOW)
    R +12ms: 0.0000V (LOW)
    R +13ms: 0.0000V (LOW)
    R +14ms: 0.0000V (LOW)
    R +15ms: 0.0000V (LOW)
    R +16ms: 0.0000V (LOW)
    R +17ms: 0.0000V (LOW)
    R +18ms: 0.0000V (LOW)
    R +19ms: 0.0000V (LOW)

  SF timer discharge curve (beat 2):
    R+  1ms: 0.48882V
    R+ 20ms: 0.48195V
    R+ 30ms: 0.47765V
    R+ 50ms: 0.46927V
    R+ 80ms: 0.45674V
    R+120ms: 0.44012V
    R+200ms: 0.40707V
    R+350ms: 0.34569V

  Comparator LEVEL outputs (beat 2):
     ms  s14_lev  wid_lev  s69_lev   bi_lev
  R+ 30    0.8992   0.3939   0.2269   0.1307
  R+ 50    0.9000   0.8590   0.2405   0.1311
  R+ 80    0.9000   0.8789   0.8303   0.1318
  R+120    0.9000   0.8885   0.8787   0.1331
  R+200    0.9000   0.8958   0.8931   0.1394
  R+350    0.9000   0.8993   0.8988   0.8782

  RR timer discharge curve (beat 2, detected):
     ms  net_timer     sf_out  timer_out
  R+  5     0.89999    0.48776    0.48776
  R+ 50     0.89548    0.48388    0.48388
  R+100     0.88993    0.47937    0.47937
  R+200     0.87884    0.47030    0.47030
  R+300     0.86776    0.46105    0.46105
  R+400     0.85669    0.45227    0.45227
  R+500     0.84564    0.44327    0.44327
  R+600     0.83459    0.43431    0.43431

  Pwave predictor on delay timer SF (beat 2->4, 1580ms):
    %RR     dt_sf  pw_base_l  pw_base_b  pw_peak_b
   50%    0.45297    0.37752    0.89699    0.00011
   65%    0.39208    0.04272    0.00000    0.00000
   75%    0.32783    0.04561    0.00000    0.00000
   85%    0.26439    0.06832    0.00000    0.00000
   90%    0.23317    0.87278    0.90000    0.00000
   95%    0.20213    0.89114    0.90000    0.90000

  Buffered (inverter pair) outputs (beat 2):
     ms  buf_s14  buf_wid  buf_s69
  R+ 30    0.9000   0.9000   0.0000
  R+ 50    0.9000   0.9000   0.0000
  R+ 80    0.9000   0.9000   0.9000
  R+120    0.9000   0.9000   0.9000

  trig_s14 (target R+14ms, beat 2):
    R+ 15ms: 0.9000V  <-- PULSE
    R+ 16ms: 0.9000V  <-- PULSE
  trig_wid (target R+28ms, beat 2):
    R+ 29ms: 0.9000V  <-- PULSE
    R+ 30ms: 0.9000V  <-- PULSE
  trig_s69 (target R+69ms, beat 2):
    R+ 69ms: 0.9000V  <-- PULSE
    R+ 70ms: 0.9000V  <-- PULSE

  Pwave trigger outputs (beat 2, RR=791ms):
     ms   pw_base   pw_peak    rr_cap
  R+691     0.0000    0.0000    0.0000
  R+701     0.0000    0.0000    0.0000
  R+711     0.0000    0.0000    0.0000
  R+721     0.0000    0.0000    0.0000
  R+731     0.0000    0.0000    0.0000
  R+741     0.0000    0.0000    0.0000
  R+751     0.0000    0.0000   -0.0000
  R+761     0.0000    0.0000    0.0000
  R+771     0.0000    0.0000    0.0000
  R+781     0.0000    0.0000    0.0000

  BI copy trigger timing (beat 2):
     ms   trig_bi    buf_bi
  R+315     0.0000    0.9000
  R+316     0.0000    0.9000
  R+317     0.0000    0.9000
  R+318     0.0000    0.9000
  R+319     0.0000    0.9000
  R+320     0.0000    0.9000
  R+321     0.0000    0.9000
  R+322     0.0000    0.9000
  R+323     0.0000    0.9000
  R+324     0.0000    0.9000
  R+325     0.0000    0.9000
  R+330     0.0000    0.9000
  R+340     0.0000    0.9000

  Pwave base trigger timing (beat 2):
     ms  trig_pwb   buf_pwb
  R+600     0.0000     N/A  
  R+602     0.0000     N/A  
  R+604     0.0000     N/A  
  R+606     0.0000     N/A  
  R+608     0.0000     N/A  
  R+610     0.0000     N/A  
  R+612     0.0000     N/A  
  R+614     0.0000     N/A  
  R+616     0.0000     N/A  
  R+618     0.0000     N/A  
  R+620     0.0000     N/A  
  R+622     0.0000     N/A  
  R+624     0.0000     N/A  
  R+626     0.0000     N/A  
  R+628     0.0000     N/A  
  R+630     0.0000     N/A  
  R+632     0.0000     N/A  
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
  F6  +0.9804  +0.9804   35     10.7       PASS
  F7  +0.7103  +0.7103   35     26.6       PASS
  F8  +0.8325  +0.1273   35     13.0       PASS

PHASE 1 PASSED — Analog chain producing valid features
Proceeding to Phase 2 (40 beats)...

============================================================
