kadgitub7/Leaky-Integrate-Fire---SNN-model-on-FPGA/LTSpice_sim/ota_core/ota_core_sigmoid_test.png

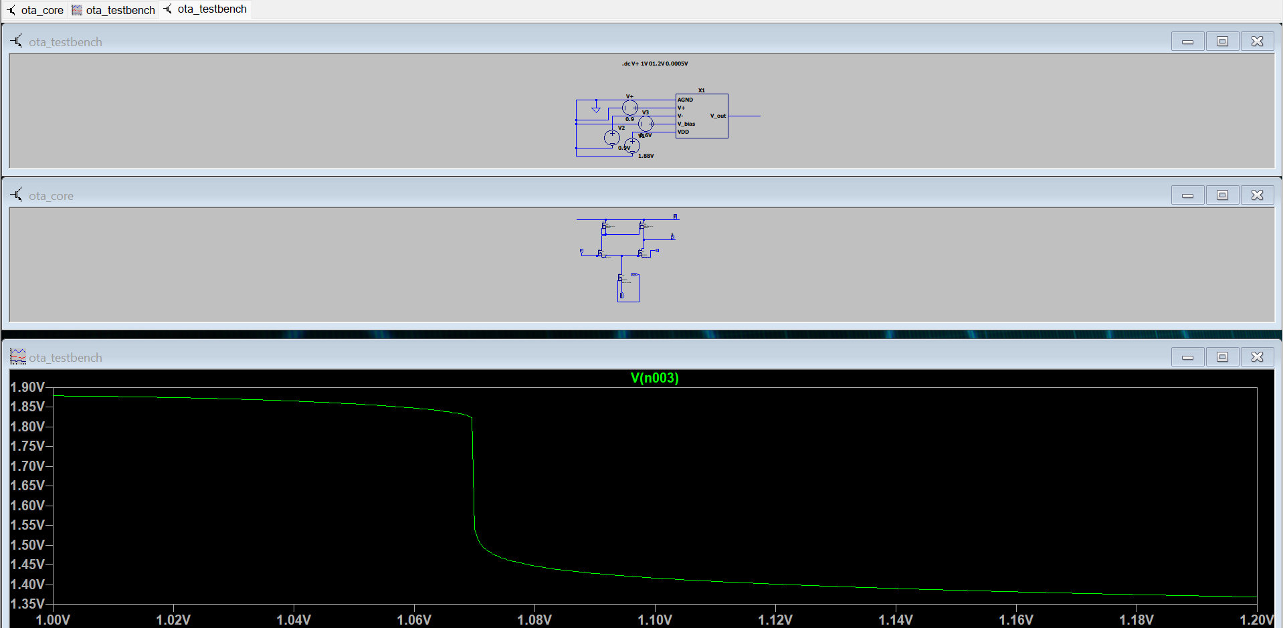
LTSpice_sim/ota_core/ota_core_sigmoid_test.png
