kadgitub7/Leaky-Integrate-Fire---SNN-model-on-FPGA/experiments/integration/_debug_scatter.png

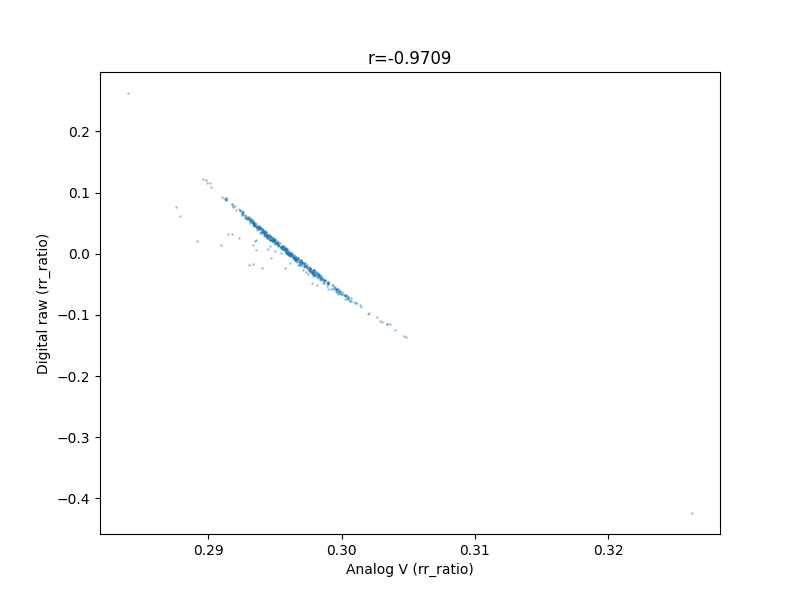
experiments/integration/_debug_scatter.png
