kadgitub7/Leaky-Integrate-Fire---SNN-model-on-FPGA/LTSpice_sim/ota_testbench.asc

V+: voltage; 0.9
V-: voltage; 0.9V
V_bias: voltage; 0.6V
Vdd: voltage; 1.88V
X1: ota_core
Named nets: 0, V_out
.dc V+ 0V 01.2V 0.0005V
