kadgitub7/Leaky-Integrate-Fire---SNN-model-on-FPGA/experiments/integration/integrated_classifier.spice

* =================================================================
* INTEGRATED CLASSIFIER: Analog Frontend Voltages -> Class Output
* Architecture: 8 -> 64 -> 5 MLP on ReRAM Crossbar
* VCVS calibrated for analog frontend voltage inputs
* =================================================================
*
* Input:  feat0..feat7 (analog frontend voltages, CLASSIFIER order)
*         feat0=rr_ratio, feat1=bi_L1, feat2=rr_asym, feat3=pwave,
*         feat4=width, feat5=bi_L0, feat6=slope, feat7=symmetry
* Output: out0..out4 (one-hot: N, S, V, F, Q)
*
* V_READ = 0.15V, G_range = [0.296, 99.273] uS
* L1 scale = 1.3705e+05, L2 scale = 1.9785e+05

.include "C:/src/skywater-pdk-libs-sky130_fd_pr/cells/nfet_01v8/sky130_fd_pr__nfet_01v8__tt.corner.spice"
.include "C:/src/skywater-pdk-libs-sky130_fd_pr/cells/nfet_01v8/sky130_fd_pr__nfet_01v8__mismatch.corner.spice"
.include "C:/src/skywater-pdk-libs-sky130_fd_pr/cells/pfet_01v8/sky130_fd_pr__pfet_01v8__tt.corner.spice"
.include "C:/src/skywater-pdk-libs-sky130_fd_pr/cells/pfet_01v8/sky130_fd_pr__pfet_01v8__mismatch.corner.spice"

.param sky130_fd_pr__pfet_01v8__a0_diff = 0
.param sky130_fd_pr__pfet_01v8__agidl_diff = 0
.param sky130_fd_pr__pfet_01v8__ags_diff = 0
.param sky130_fd_pr__pfet_01v8__b0_diff = 0
.param sky130_fd_pr__pfet_01v8__b1_diff = 0
.param sky130_fd_pr__pfet_01v8__bgidl_diff = 0
.param sky130_fd_pr__pfet_01v8__cgidl_diff = 0
.param sky130_fd_pr__pfet_01v8__dlc_diff = 0
.param sky130_fd_pr__pfet_01v8__dwc_diff = 0
.param sky130_fd_pr__pfet_01v8__eta0_diff = 0
.param sky130_fd_pr__pfet_01v8__k2_diff = 0
.param sky130_fd_pr__pfet_01v8__keta_diff = 0
.param sky130_fd_pr__pfet_01v8__kt1_diff = 0
.param sky130_fd_pr__pfet_01v8__ku0_diff = 0
.param sky130_fd_pr__pfet_01v8__kvsat_diff = 0
.param sky130_fd_pr__pfet_01v8__kvth0_diff = 0
.param sky130_fd_pr__pfet_01v8__lint_diff = 0
.param sky130_fd_pr__pfet_01v8__lku0_diff = 0
.param sky130_fd_pr__pfet_01v8__lkvth0_diff = 0
.param sky130_fd_pr__pfet_01v8__nfactor_diff = 0
.param sky130_fd_pr__pfet_01v8__pclm_diff = 0
.param sky130_fd_pr__pfet_01v8__pdits_diff = 0
.param sky130_fd_pr__pfet_01v8__pditsd_diff = 0
.param sky130_fd_pr__pfet_01v8__rdsw_diff = 0
.param sky130_fd_pr__pfet_01v8__tvoff_diff = 0
.param sky130_fd_pr__pfet_01v8__u0_diff = 0
.param sky130_fd_pr__pfet_01v8__ua_diff = 0
.param sky130_fd_pr__pfet_01v8__ub_diff = 0
.param sky130_fd_pr__pfet_01v8__voff_diff = 0
.param sky130_fd_pr__pfet_01v8__vsat_diff = 0
.param sky130_fd_pr__pfet_01v8__vth0_diff = 0
.param sky130_fd_pr__pfet_01v8__wint_diff = 0
.param sky130_fd_pr__pfet_01v8__wku0_diff = 0
.param sky130_fd_pr__pfet_01v8__wkvth0_diff = 0
.param sky130_fd_pr__pfet_01v8__wlod_diff = 0

Vdd vdd 0 1.8

* ===== INPUT CONDITIONING (calibrated for analog frontend) =====
* V_row_i = A_i * V_feat_i + B_i
* Maps frontend voltage to crossbar row voltage preserving trained weights

* --- Classifier channel 0 (rr_ratio) ---
* A=-6.73245132e-01, B=2.74537622e-01
Econd0 row0 0 vol='v(feat0)*-6.73245132e-01 + 2.74537622e-01'

* --- Classifier channel 1 (bi_L1) ---
* A=1.64850665e+00, B=-4.14481281e-01
Econd1 row1 0 vol='v(feat1)*1.64850665e+00 + -4.14481281e-01'

* --- Classifier channel 2 (rr_asym) ---
* A=4.41933558e-01, B=-5.74335735e-02
Econd2 row2 0 vol='v(feat2)*4.41933558e-01 + -5.74335735e-02'

* --- Classifier channel 3 (pwave) ---
* A=4.59820564e+00, B=-1.30144704e+00
Econd3 row3 0 vol='v(feat3)*4.59820564e+00 + -1.30144704e+00'

* --- Classifier channel 4 (width) ---
* A=4.92256536e-01, B=-5.30094171e-02
Econd4 row4 0 vol='v(feat4)*4.92256536e-01 + -5.30094171e-02'

* --- Classifier channel 5 (bi_L0) ---
* A=1.21032800e+00, B=-2.83835389e-01
Econd5 row5 0 vol='v(feat5)*1.21032800e+00 + -2.83835389e-01'

* --- Classifier channel 6 (slope) ---
* A=6.36230863e-01, B=-1.71504100e-01
Econd6 row6 0 vol='v(feat6)*6.36230863e-01 + -1.71504100e-01'

* --- Classifier channel 7 (symmetry) ---
* A=3.86817935e-01, B=-6.13430701e-02
Econd7 row7 0 vol='v(feat7)*3.86817935e-01 + -6.13430701e-02'

* ===== L1: 8x64 DIFFERENTIAL 1T1R ReRAM CROSSBAR =====
Vgate_l1 gate_l1 0 1.8

* --- Positive conductance array ---
XTpl1_0_0 row0 gate_l1 mpl1_0_0 0 sky130_fd_pr__nfet_01v8 W=1.0u L=0.15u
Rrpl1_0_0 mpl1_0_0 cpl1_0 54753.9180
XTpl1_0_1 row0 gate_l1 mpl1_0_1 0 sky130_fd_pr__nfet_01v8 W=1.0u L=0.15u
Rrpl1_0_1 mpl1_0_1 cpl1_1 3378378.2500
XTpl1_0_2 row0 gate_l1 mpl1_0_2 0 sky130_fd_pr__nfet_01v8 W=1.0u L=0.15u
Rrpl1_0_2 mpl1_0_2 cpl1_2 3378378.2500
XTpl1_0_3 row0 gate_l1 mpl1_0_3 0 sky130_fd_pr__nfet_01v8 W=1.0u L=0.15u
Rrpl1_0_3 mpl1_0_3 cpl1_3 3378378.2500
XTpl1_0_4 row0 gate_l1 mpl1_0_4 0 sky130_fd_pr__nfet_01v8 W=1.0u L=0.15u
Rrpl1_0_4 mpl1_0_4 cpl1_4 69037.8125
XTpl1_0_5 row0 gate_l1 mpl1_0_5 0 sky130_fd_pr__nfet_01v8 W=1.0u L=0.15u
Rrpl1_0_5 mpl1_0_5 cpl1_5 254810.7344
XTpl1_0_6 row0 gate_l1 mpl1_0_6 0 sky130_fd_pr__nfet_01v8 W=1.0u L=0.15u
Rrpl1_0_6 mpl1_0_6 cpl1_6 3378378.2500
XTpl1_0_7 row0 gate_l1 mpl1_0_7 0 sky130_fd_pr__nfet_01v8 W=1.0u L=0.15u
Rrpl1_0_7 mpl1_0_7 cpl1_7 3378378.2500
XTpl1_0_8 row0 gate_l1 mpl1_0_8 0 sky130_fd_pr__nfet_01v8 W=1.0u L=0.15u
Rrpl1_0_8 mpl1_0_8 cpl1_8 46049.4102
XTpl1_0_9 row0 gate_l1 mpl1_0_9 0 sky130_fd_pr__nfet_01v8 W=1.0u L=0.15u
Rrpl1_0_9 mpl1_0_9 cpl1_9 193673.0000
XTpl1_0_10 row0 gate_l1 mpl1_0_10 0 sky130_fd_pr__nfet_01v8 W=1.0u L=0.15u
Rrpl1_0_10 mpl1_0_10 cpl1_10 85784.4688
XTpl1_0_11 row0 gate_l1 mpl1_0_11 0 sky130_fd_pr__nfet_01v8 W=1.0u L=0.15u
Rrpl1_0_11 mpl1_0_11 cpl1_11 83855.5469
XTpl1_0_12 row0 gate_l1 mpl1_0_12 0 sky130_fd_pr__nfet_01v8 W=1.0u L=0.15u
Rrpl1_0_12 mpl1_0_12 cpl1_12 3378378.2500
XTpl1_0_13 row0 gate_l1 mpl1_0_13 0 sky130_fd_pr__nfet_01v8 W=1.0u L=0.15u
Rrpl1_0_13 mpl1_0_13 cpl1_13 3378378.2500
XTpl1_0_14 row0 gate_l1 mpl1_0_14 0 sky130_fd_pr__nfet_01v8 W=1.0u L=0.15u
Rrpl1_0_14 mpl1_0_14 cpl1_14 51308.5352
XTpl1_0_15 row0 gate_l1 mpl1_0_15 0 sky130_fd_pr__nfet_01v8 W=1.0u L=0.15u
Rrpl1_0_15 mpl1_0_15 cpl1_15 36603.6719
XTpl1_0_16 row0 gate_l1 mpl1_0_16 0 sky130_fd_pr__nfet_01v8 W=1.0u L=0.15u
Rrpl1_0_16 mpl1_0_16 cpl1_16 134982.8125
XTpl1_0_17 row0 gate_l1 mpl1_0_17 0 sky130_fd_pr__nfet_01v8 W=1.0u L=0.15u
Rrpl1_0_17 mpl1_0_17 cpl1_17 527915.0000
XTpl1_0_18 row0 gate_l1 mpl1_0_18 0 sky130_fd_pr__nfet_01v8 W=1.0u L=0.15u
Rrpl1_0_18 mpl1_0_18 cpl1_18 48783.1836
XTpl1_0_19 row0 gate_l1 mpl1_0_19 0 sky130_fd_pr__nfet_01v8 W=1.0u L=0.15u
Rrpl1_0_19 mpl1_0_19 cpl1_19 3378378.2500
XTpl1_0_20 row0 gate_l1 mpl1_0_20 0 sky130_fd_pr__nfet_01v8 W=1.0u L=0.15u
Rrpl1_0_20 mpl1_0_20 cpl1_20 3378378.2500
XTpl1_0_21 row0 gate_l1 mpl1_0_21 0 sky130_fd_pr__nfet_01v8 W=1.0u L=0.15u
Rrpl1_0_21 mpl1_0_21 cpl1_21 3378378.2500
XTpl1_0_22 row0 gate_l1 mpl1_0_22 0 sky130_fd_pr__nfet_01v8 W=1.0u L=0.15u
Rrpl1_0_22 mpl1_0_22 cpl1_22 78530.8750
XTpl1_0_23 row0 gate_l1 mpl1_0_23 0 sky130_fd_pr__nfet_01v8 W=1.0u L=0.15u
Rrpl1_0_23 mpl1_0_23 cpl1_23 43984.6172
XTpl1_0_24 row0 gate_l1 mpl1_0_24 0 sky130_fd_pr__nfet_01v8 W=1.0u L=0.15u
Rrpl1_0_24 mpl1_0_24 cpl1_24 58847.1719
XTpl1_0_25 row0 gate_l1 mpl1_0_25 0 sky130_fd_pr__nfet_01v8 W=1.0u L=0.15u
Rrpl1_0_25 mpl1_0_25 cpl1_25 111631.7266
XTpl1_0_26 row0 gate_l1 mpl1_0_26 0 sky130_fd_pr__nfet_01v8 W=1.0u L=0.15u
Rrpl1_0_26 mpl1_0_26 cpl1_26 149268.2188
XTpl1_0_27 row0 gate_l1 mpl1_0_27 0 sky130_fd_pr__nfet_01v8 W=1.0u L=0.15u
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
Rrpl1_3_26 mpl1_3_26 cpl1_26 64146.7500
XTpl1_3_27 row3 gate_l1 mpl1_3_27 0 sky130_fd_pr__nfet_01v8 W=1.0u L=0.15u
Rrpl1_3_27 mpl1_3_27 cpl1_27 55918.2031
XTpl1_3_28 row3 gate_l1 mpl1_3_28 0 sky130_fd_pr__nfet_01v8 W=1.0u L=0.15u
Rrpl1_3_28 mpl1_3_28 cpl1_28 42947.6172
XTpl1_3_29 row3 gate_l1 mpl1_3_29 0 sky130_fd_pr__nfet_01v8 W=1.0u L=0.15u
Rrpl1_3_29 mpl1_3_29 cpl1_29 3378378.2500
XTpl1_3_30 row3 gate_l1 mpl1_3_30 0 sky130_fd_pr__nfet_01v8 W=1.0u L=0.15u
Rrpl1_3_30 mpl1_3_30 cpl1_30 197410.9531
XTpl1_3_31 row3 gate_l1 mpl1_3_31 0 sky130_fd_pr__nfet_01v8 W=1.0u L=0.15u
Rrpl1_3_31 mpl1_3_31 cpl1_31 3378378.2500
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
