kadgitub7/Leaky-Integrate-Fire---SNN-model-on-FPGA/LTSpice_sim/full_frontend/normalizer_test.asc

V_Bias: voltage; 0.65V
V_feature: voltage; 0.9V
V_mean: voltage; 0.857V
VDD: voltage; 1.88V
Vref: voltage; 0.9V
X1: normalizer
Named nets: 0, v_norm
.op
