kadgitub7/Leaky-Integrate-Fire---SNN-model-on-FPGA/LTSpice_sim/bandpass/ota_bandpass_test.asc

bandpass: ota_bandpass
LP_0.5: voltage; 0.9V; AC 1
LP_0.08: voltage; 0.9V
V_Bias: voltage; 0.6V
VDD: voltage; 1.88V
Named nets: 0, Vout
.ac dec 10 1 1Meg
.nodeset V(vout)=0.9
