kadgitub7/Leaky-Integrate-Fire---SNN-model-on-FPGA/LTSpice_sim/Gated_Entry_Integrator/gated_integrator_test.asc

RST: voltage; PULSE(0 1.88 0 1n 1n 5m 500m)
V_bias: voltage; 0.65V
Vdd: voltage; 1.88V
Vin: voltage; 1.0V
Vref: voltage; 0.9V
WINDOW: voltage; PULSE(0 1.88 10m 1n 1n 110m 500m)
X1: gated_integrator
Named nets: 0, V_energy
.tran 0 200m
