kadgitub7/Leaky-Integrate-Fire---SNN-model-on-FPGA/LTSpice_sim/precision_fullwave/precision_fullwave_test.asc

precision_fullwave: precision_fullwave
V_bias: voltage; 0.65V
Vdd: voltage; 1.88V
Vin: voltage; SINE(0.9 0.1 50)
Vref: voltage; 0.9V
Named nets: 0, V_rect
.tran 0 100m
.nodeset V(v_rect)=0.9
