kadgitub7/Leaky-Integrate-Fire---SNN-model-on-FPGA/LTSpice_sim/QRS_amp/qrs_amp_test.asc

V_bias: voltage; 0.65V
V_dd: voltage; 1.88V
V_max: voltage; 0.95V
V_min: voltage; 0.85V
Vref: voltage; 0.9V
X1: qrs_amp
Named nets: 0, V_amp
.op
