kadgitub7/Leaky-Integrate-Fire---SNN-model-on-FPGA/LTSpice_sim/sample_and_hold/sample_and_hold_test.asc

CLK_s: voltage; PULSE(0 1.88 0 1n 1n 1m 22.222m)
sample_and_hold: sample_and_hold
V_bias: voltage; 0.65V
V_filter: voltage; SINE(0.9 0.1 50)
Vdd: voltage; 1.88V
Named nets: 0, V_held
.tran 0 200m
