kadgitub7/Leaky-Integrate-Fire---SNN-model-on-FPGA/LTSpice_sim/second_derivative/second_derivative_test.asc

SD: second_derivative
V_bias: voltage; 0.83V
Vdd: voltage; 1.88V
Vin: voltage; 0.9V; AC 1
Vref: voltage; 0.9V
Named nets: 0, V_d2
.ac dec 10 1 1Meg
.nodeset V(v_d2)=0.9
