kadgitub7/Leaky-Integrate-Fire---SNN-model-on-FPGA/LTSpice_sim/valley_detector/valley_detector_test.asc

RST: voltage; PULSE(0 1.88 0 1n 1n 1m 50m)
V_bias: voltage; 0.65V
valley_detector: valley_detector
Vdd: voltage; 1.88V
Vin: voltage; SINE(0.9 0.1 50)
Named nets: 0, V_valley
.tran 0 200m
