kadgitub7/Leaky-Integrate-Fire---SNN-model-on-FPGA/experiments/Complete_imp/classifier_crossbar/L1_crossbar_8x64_circuit.spice

* =================================================================
* LAYER 1 (circuit features): 8x64 Differential 1T1R ReRAM Crossbar
* Trained on CIRCUIT-MATCHING features (analog differences, alpha=0.015)
* Technology: SKY130 sky130_fd_pr__nfet_01v8 (W=1.0u L=0.15u)
* =================================================================
*
* Conductance range: 0.296 - 99.273 uS (SKY130 ReRAM PDK)
* V_READ = 0.15V, V_GATE = 1.8V
* Scale factor: 1.701263e+05
* Total 1T1R cells: 1024 (differential)
*
* Biases (add after current sensing):
*   b[0] = -0.096853
*   b[1] = -0.193053
*   b[2] = -0.311981
*   b[3] = 0.417632
*   b[4] = 0.386167
*   b[5] = 0.100687
*   b[6] = 0.767024
*   b[7] = 0.024898
*   b[8] = -0.613583
*   b[9] = -0.554008
*   b[10] = -0.229366
*   b[11] = 0.741658
*   b[12] = -0.720304
*   b[13] = 0.621754
*   b[14] = 0.397682
*   b[15] = 0.584104
*   b[16] = 0.115474
*   b[17] = -0.331603
*   b[18] = 0.979647
*   b[19] = -0.428521
*   b[20] = 0.066221
*   b[21] = 0.331739
*   b[22] = 0.267301
*   b[23] = -0.145383
*   b[24] = 0.318282
*   b[25] = -0.376879
*   b[26] = 0.241927
*   b[27] = -0.555084
*   b[28] = 0.250274
*   b[29] = -0.810719
*   b[30] = 0.028195
*   b[31] = 0.848577
*   b[32] = -0.163557
*   b[33] = 0.037470
*   b[34] = -0.975942
*   b[35] = 0.563542
*   b[36] = -0.076901
*   b[37] = -0.070415
*   b[38] = 0.119175
*   b[39] = 0.067931
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
* =================================================================

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
Rrp3_21 mp3_21 cp21 3378378.3784  $ G+=0.296uS w=-0.1783
XTp3_22 row3 gate mp3_22 0 sky130_fd_pr__nfet_01v8 W=1.0u L=0.15u
Rrp3_22 mp3_22 cp22 60179.7603  $ G+=16.617uS w=0.4165
XTp3_23 row3 gate mp3_23 0 sky130_fd_pr__nfet_01v8 W=1.0u L=0.15u
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
