kadgitub7/Leaky-Integrate-Fire---SNN-model-on-FPGA/experiments/Complete_imp/classifier_crossbar/L2_crossbar_64x5_circuit.spice

* =================================================================
* LAYER 2 (circuit features): 64x5 Differential 1T1R ReRAM Crossbar
* Trained on CIRCUIT-MATCHING features (analog differences, alpha=0.015)
* Technology: SKY130 sky130_fd_pr__nfet_01v8 (W=1.0u L=0.15u)
* =================================================================
*
* Conductance range: 0.296 - 99.273 uS (SKY130 ReRAM PDK)
* V_READ = 0.15V, V_GATE = 1.8V
* Scale factor: 1.857207e+05
* Total 1T1R cells: 640 (differential)
*
* Biases (add after current sensing):
*   b[0] = 0.117655
*   b[1] = -0.150355
*   b[2] = -0.481003
*   b[3] = 0.267557
*   b[4] = -0.302589
* =================================================================

.include "C:/src/skywater-pdk-libs-sky130_fd_pr/cells/nfet_01v8/sky130_fd_pr__nfet_01v8__tt.corner.spice"
.include "C:/src/skywater-pdk-libs-sky130_fd_pr/cells/nfet_01v8/sky130_fd_pr__nfet_01v8__mismatch.corner.spice"

Vgate gate 0 1.8

* --- Row inputs ---
Vrow0 row0 0 0.0
Vrow1 row1 0 0.0
Vrow2 row2 0 0.0
Vrow3 row3 0 0.0
Vrow4 row4 0 0.0
Vrow5 row5 0 0.0
Vrow6 row6 0 0.0
Vrow7 row7 0 0.0
Vrow8 row8 0 0.0
Vrow9 row9 0 0.0
Vrow10 row10 0 0.0
Vrow11 row11 0 0.0
Vrow12 row12 0 0.0
Vrow13 row13 0 0.0
Vrow14 row14 0 0.0
Vrow15 row15 0 0.0
Vrow16 row16 0 0.0
Vrow17 row17 0 0.0
Vrow18 row18 0 0.0
Vrow19 row19 0 0.0
Vrow20 row20 0 0.0
Vrow21 row21 0 0.0
Vrow22 row22 0 0.0
Vrow23 row23 0 0.0
Vrow24 row24 0 0.0
Vrow25 row25 0 0.0
Vrow26 row26 0 0.0
Vrow27 row27 0 0.0
Vrow28 row28 0 0.0
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
Rrp42_2 mp42_2 cp2 2203343.2671  $ G+=0.454uS w=0.0044
XTp42_3 row42 gate mp42_3 0 sky130_fd_pr__nfet_01v8 W=1.0u L=0.15u
Rrp42_3 mp42_3 cp3 153552.5147  $ G+=6.512uS w=0.1732
XTp42_4 row42 gate mp42_4 0 sky130_fd_pr__nfet_01v8 W=1.0u L=0.15u
Rrp42_4 mp42_4 cp4 3378378.3784  $ G+=0.296uS w=-0.5474
* --- Row 43 ---
XTp43_0 row43 gate mp43_0 0 sky130_fd_pr__nfet_01v8 W=1.0u L=0.15u
Rrp43_0 mp43_0 cp0 3378378.3784  $ G+=0.296uS w=-0.6212
XTp43_1 row43 gate mp43_1 0 sky130_fd_pr__nfet_01v8 W=1.0u L=0.15u
Rrp43_1 mp43_1 cp1 42061.0744  $ G+=23.775uS w=0.6541
XTp43_2 row43 gate mp43_2 0 sky130_fd_pr__nfet_01v8 W=1.0u L=0.15u
Rrp43_2 mp43_2 cp2 3378378.3784  $ G+=0.296uS w=-0.1820
XTp43_3 row43 gate mp43_3 0 sky130_fd_pr__nfet_01v8 W=1.0u L=0.15u
Rrp43_3 mp43_3 cp3 40706.7074  $ G+=24.566uS w=0.6761
XTp43_4 row43 gate mp43_4 0 sky130_fd_pr__nfet_01v8 W=1.0u L=0.15u
Rrp43_4 mp43_4 cp4 3378378.3784  $ G+=0.296uS w=-0.1228
* --- Row 44 ---
XTp44_0 row44 gate mp44_0 0 sky130_fd_pr__nfet_01v8 W=1.0u L=0.15u
Rrp44_0 mp44_0 cp0 3378378.3784  $ G+=0.296uS w=-0.4006
XTp44_1 row44 gate mp44_1 0 sky130_fd_pr__nfet_01v8 W=1.0u L=0.15u
Rrp44_1 mp44_1 cp1 3378378.3784  $ G+=0.296uS w=-0.5748
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
