kadgitub7/Leaky-Integrate-Fire---SNN-model-on-FPGA/experiments/Complete_imp/classifier_crossbar/top_level_classifier.spice

* =================================================================
* TOP-LEVEL: Complete Analog ECG Classifier
* Architecture: 8 -> 64 -> 5 MLP on ReRAM Crossbar
* Technology: SKY130 (NFET/PFET 01v8 + ReRAM)
* =================================================================
*
* Signal path (fully analog):
*   feat0..feat7 (8 raw feature voltages)
*     -> Input Conditioning (analog normalization: gain + offset)
*     -> row0..row7 (normalized voltages, scaled to V_READ domain)
*     -> L1 Crossbar (8x64 differential 1T1R ReRAM)
*     -> 64 differential column currents
*     -> L1 Interstage (64 channels):
*         - Current-mirror bias injection (PMOS/NMOS per channel)
*         - NMOS current-mirror ReLU (diode clamp)
*         - Output PMOS mirror -> voltage for L2 rows
*     -> L2 Crossbar (64x5 differential 1T1R ReRAM)
*     -> 5 differential column currents
*     -> L2 Bias injection (5 current mirrors)
*     -> Lazzaro WTA (5-input analog argmax)
*     -> out0..out4 (one-hot voltage output)
*
* L1 scale: 1.7013e+05,  L2 scale: 1.8572e+05
* V_READ: 0.15V,  VDD: 1.8V
* L1 cells: 1024 1T1R,  L2 cells: 640 1T1R
* =================================================================

.include "C:/src/skywater-pdk-libs-sky130_fd_pr/cells/nfet_01v8/sky130_fd_pr__nfet_01v8__tt.corner.spice"
.include "C:/src/skywater-pdk-libs-sky130_fd_pr/cells/nfet_01v8/sky130_fd_pr__nfet_01v8__mismatch.corner.spice"
.include "C:/src/skywater-pdk-libs-sky130_fd_pr/cells/pfet_01v8/sky130_fd_pr__pfet_01v8__tt.corner.spice"
.include "C:/src/skywater-pdk-libs-sky130_fd_pr/cells/pfet_01v8/sky130_fd_pr__pfet_01v8__mismatch.corner.spice"
.param sky130_fd_pr__pfet_01v8__a0_diff = 0
.param sky130_fd_pr__pfet_01v8__agidl_diff = 0
.param sky130_fd_pr__pfet_01v8__ags_diff = 0
.param sky130_fd_pr__pfet_01v8__b0_diff = 0
.param sky130_fd_pr__pfet_01v8__b1_diff = 0
.param sky130_fd_pr__pfet_01v8__bgidl_diff = 0
.param sky130_fd_pr__pfet_01v8__cgidl_diff = 0
.param sky130_fd_pr__pfet_01v8__dlc_diff = 0
.param sky130_fd_pr__pfet_01v8__dwc_diff = 0
.param sky130_fd_pr__pfet_01v8__eta0_diff = 0
.param sky130_fd_pr__pfet_01v8__k2_diff = 0
.param sky130_fd_pr__pfet_01v8__keta_diff = 0
.param sky130_fd_pr__pfet_01v8__kt1_diff = 0
.param sky130_fd_pr__pfet_01v8__ku0_diff = 0
.param sky130_fd_pr__pfet_01v8__kvsat_diff = 0
.param sky130_fd_pr__pfet_01v8__kvth0_diff = 0
.param sky130_fd_pr__pfet_01v8__lint_diff = 0
.param sky130_fd_pr__pfet_01v8__lku0_diff = 0
.param sky130_fd_pr__pfet_01v8__lkvth0_diff = 0
.param sky130_fd_pr__pfet_01v8__nfactor_diff = 0
.param sky130_fd_pr__pfet_01v8__pclm_diff = 0
.param sky130_fd_pr__pfet_01v8__pdits_diff = 0
.param sky130_fd_pr__pfet_01v8__pditsd_diff = 0
.param sky130_fd_pr__pfet_01v8__rdsw_diff = 0
.param sky130_fd_pr__pfet_01v8__tvoff_diff = 0
.param sky130_fd_pr__pfet_01v8__u0_diff = 0
.param sky130_fd_pr__pfet_01v8__ua_diff = 0
.param sky130_fd_pr__pfet_01v8__ub_diff = 0
.param sky130_fd_pr__pfet_01v8__voff_diff = 0
.param sky130_fd_pr__pfet_01v8__vsat_diff = 0
.param sky130_fd_pr__pfet_01v8__vth0_diff = 0
.param sky130_fd_pr__pfet_01v8__wint_diff = 0
.param sky130_fd_pr__pfet_01v8__wku0_diff = 0
.param sky130_fd_pr__pfet_01v8__wkvth0_diff = 0
.param sky130_fd_pr__pfet_01v8__wlod_diff = 0

* --- Supply ---
VDD vdd 0 1.8

* --- Feature inputs (8 raw ECG feature voltages) ---
Vfeat0 feat0 0 0.0
Vfeat1 feat1 0 0.0
Vfeat2 feat2 0 0.0
Vfeat3 feat3 0 0.0
Vfeat4 feat4 0 0.0
Vfeat5 feat5 0 0.0
Vfeat6 feat6 0 0.0
Vfeat7 feat7 0 0.0

* ===== INPUT CONDITIONING (8 channels) =====
* Offset-binary normalization: maps normalized features to [0, V_READ]
* x_norm = (V_feat - mean) / scale; V_row = (x_norm + 4.0) * V_READ / 8.0
* Constant offset current absorbed into bias mirrors
* ASIC: differential amplifier with resistive feedback per channel

* --- Feature 0: mean=-0.001966, scale=0.469741 ---
* gain=3.99155737e-02 V/V, V_row = gain*V_feat + 7.50784630e-02
Econd0 row0 0 vol='v(feat0)*3.99155737e-02 + 7.50784630e-02'

* --- Feature 1: mean=-0.000008, scale=0.384009 ---
* gain=4.88270111e-02 V/V, V_row = gain*V_feat + 7.50003880e-02
Econd1 row1 0 vol='v(feat1)*4.88270111e-02 + 7.50003880e-02'

* --- Feature 2: mean=-0.000038, scale=0.658086 ---
* gain=2.84917140e-02 V/V, V_row = gain*V_feat + 7.50010917e-02
Econd2 row2 0 vol='v(feat2)*2.84917140e-02 + 7.50010917e-02'

* --- Feature 3: mean=0.013629, scale=0.140897 ---
* gain=1.33076214e-01 V/V, V_row = gain*V_feat + 7.31862608e-02
Econd3 row3 0 vol='v(feat3)*1.33076214e-01 + 7.31862608e-02'

* --- Feature 4: mean=-0.573710, scale=0.381370 ---
* gain=4.91648705e-02 V/V, V_row = gain*V_feat + 1.03206391e-01
Econd4 row4 0 vol='v(feat4)*4.91648705e-02 + 1.03206391e-01'

* --- Feature 5: mean=0.000029, scale=0.512142 ---
* gain=3.66109250e-02 V/V, V_row = gain*V_feat + 7.49989512e-02
Econd5 row5 0 vol='v(feat5)*3.66109250e-02 + 7.49989512e-02'

* --- Feature 6: mean=0.814082, scale=0.743661 ---
* gain=2.52131149e-02 V/V, V_row = gain*V_feat + 5.44744521e-02
Econd6 row6 0 vol='v(feat6)*2.52131149e-02 + 5.44744521e-02'

* --- Feature 7: mean=0.901827, scale=0.837629 ---
* gain=2.23846220e-02 V/V, V_row = gain*V_feat + 5.48129528e-02
Econd7 row7 0 vol='v(feat7)*2.23846220e-02 + 5.48129528e-02'

* ===== LAYER 1: 8x64 DIFFERENTIAL 1T1R ReRAM CROSSBAR =====
Vgate_l1 gate_l1 0 1.8

* --- Positive conductance array ---
XTpl1_0_0 row0 gate_l1 mpl1_0_0 0 sky130_fd_pr__nfet_01v8 W=1.0u L=0.15u
Rrpl1_0_0 mpl1_0_0 cpl1_0 3378378.3784
XTpl1_0_1 row0 gate_l1 mpl1_0_1 0 sky130_fd_pr__nfet_01v8 W=1.0u L=0.15u
Rrpl1_0_1 mpl1_0_1 cpl1_1 23959.8400
XTpl1_0_2 row0 gate_l1 mpl1_0_2 0 sky130_fd_pr__nfet_01v8 W=1.0u L=0.15u
Rrpl1_0_2 mpl1_0_2 cpl1_2 3378378.3784
XTpl1_0_3 row0 gate_l1 mpl1_0_3 0 sky130_fd_pr__nfet_01v8 W=1.0u L=0.15u
Rrpl1_0_3 mpl1_0_3 cpl1_3 3378378.3784
XTpl1_0_4 row0 gate_l1 mpl1_0_4 0 sky130_fd_pr__nfet_01v8 W=1.0u L=0.15u
Rrpl1_0_4 mpl1_0_4 cpl1_4 88687.0034
XTpl1_0_5 row0 gate_l1 mpl1_0_5 0 sky130_fd_pr__nfet_01v8 W=1.0u L=0.15u
Rrpl1_0_5 mpl1_0_5 cpl1_5 224898.6095
XTpl1_0_6 row0 gate_l1 mpl1_0_6 0 sky130_fd_pr__nfet_01v8 W=1.0u L=0.15u
Rrpl1_0_6 mpl1_0_6 cpl1_6 83313.1320
XTpl1_0_7 row0 gate_l1 mpl1_0_7 0 sky130_fd_pr__nfet_01v8 W=1.0u L=0.15u
Rrpl1_0_7 mpl1_0_7 cpl1_7 258294.4994
XTpl1_0_8 row0 gate_l1 mpl1_0_8 0 sky130_fd_pr__nfet_01v8 W=1.0u L=0.15u
Rrpl1_0_8 mpl1_0_8 cpl1_8 58439.3591
XTpl1_0_9 row0 gate_l1 mpl1_0_9 0 sky130_fd_pr__nfet_01v8 W=1.0u L=0.15u
Rrpl1_0_9 mpl1_0_9 cpl1_9 86515.9819
XTpl1_0_10 row0 gate_l1 mpl1_0_10 0 sky130_fd_pr__nfet_01v8 W=1.0u L=0.15u
Rrpl1_0_10 mpl1_0_10 cpl1_10 3378378.3784
XTpl1_0_11 row0 gate_l1 mpl1_0_11 0 sky130_fd_pr__nfet_01v8 W=1.0u L=0.15u
Rrpl1_0_11 mpl1_0_11 cpl1_11 3378378.3784
XTpl1_0_12 row0 gate_l1 mpl1_0_12 0 sky130_fd_pr__nfet_01v8 W=1.0u L=0.15u
Rrpl1_0_12 mpl1_0_12 cpl1_12 3378378.3784
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
Rrpl1_3_11 mpl1_3_11 cpl1_11 202232.0880
XTpl1_3_12 row3 gate_l1 mpl1_3_12 0 sky130_fd_pr__nfet_01v8 W=1.0u L=0.15u
Rrpl1_3_12 mpl1_3_12 cpl1_12 2444366.5761
XTpl1_3_13 row3 gate_l1 mpl1_3_13 0 sky130_fd_pr__nfet_01v8 W=1.0u L=0.15u
Rrpl1_3_13 mpl1_3_13 cpl1_13 133969.3788
XTpl1_3_14 row3 gate_l1 mpl1_3_14 0 sky130_fd_pr__nfet_01v8 W=1.0u L=0.15u
Rrpl1_3_14 mpl1_3_14 cpl1_14 373836.9893
XTpl1_3_15 row3 gate_l1 mpl1_3_15 0 sky130_fd_pr__nfet_01v8 W=1.0u L=0.15u
Rrpl1_3_15 mpl1_3_15 cpl1_15 2148328.0516
XTpl1_3_16 row3 gate_l1 mpl1_3_16 0 sky130_fd_pr__nfet_01v8 W=1.0u L=0.15u
Rrpl1_3_16 mpl1_3_16 cpl1_16 498218.6777
XTpl1_3_17 row3 gate_l1 mpl1_3_17 0 sky130_fd_pr__nfet_01v8 W=1.0u L=0.15u
Rrpl1_3_17 mpl1_3_17 cpl1_17 72546.3214
XTpl1_3_18 row3 gate_l1 mpl1_3_18 0 sky130_fd_pr__nfet_01v8 W=1.0u L=0.15u
Rrpl1_3_18 mpl1_3_18 cpl1_18 769708.9570
XTpl1_3_19 row3 gate_l1 mpl1_3_19 0 sky130_fd_pr__nfet_01v8 W=1.0u L=0.15u
Rrpl1_3_19 mpl1_3_19 cpl1_19 3378378.3784
XTpl1_3_20 row3 gate_l1 mpl1_3_20 0 sky130_fd_pr__nfet_01v8 W=1.0u L=0.15u
Rrpl1_3_20 mpl1_3_20 cpl1_20 78331.9250
XTpl1_3_21 row3 gate_l1 mpl1_3_21 0 sky130_fd_pr__nfet_01v8 W=1.0u L=0.15u
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
