kadgitub7/Leaky-Integrate-Fire---SNN-model-on-FPGA/experiments/frontend_optimization/complete_frontend_v9b/_diag_D_pred_pwave.spice

.title diag_D_pred_pwave
.lib "C:/Users/kadhi/OneDrive/Desktop/amux/verilogLearning/Leaky-Integrate-Fire---SNN-model-on-FPGA/experiments/frontend_optimization/ngspice_frontend/sky130_minimal.lib.spice" tt
.option scale=1.0u method=gear reltol=0.01 gmin=1e-15
.temp 27
Vdd vdd 0 0.9
Vss vss 0 0
Vecg0 ecg_l0 0 PWL(0.0000000 0.300000 0.5608889 0.300000 0.5638889 0.282026 0.5666667 0.281731 0.5694444 0.282320 0.5722222 0.282026 0.5750000 0.282910 0.5777778 0.282320 0.5805556 0.282320 0.5833333 0.282026 0.5861111 0.282026 0.5888889 0.282910 0.5916667 0.283499 0.5944444 0.282615 0.5972222 0.282026 0.6000000 0.281436 0.6027778 0.282026 0.6055556 0.282615 0.6083333 0.282910 0.6111111 0.283499 0.6138889 0.284088 0.6166667 0.283794 0.6194444 0.283794 0.6222222 0.284088 0.6250000 0.285267 0.6277778 0.285267 0.6305556 0.284972 0.6333333 0.286740 0.6361111 0.287035 0.6388889 0.287919 0.6416667 0.288214 0.6444444 0.287919 0.6472222 0.287330 0.6500000 0.286446 0.6527778 0.287035 0.6555556 0.286740 0.6583333 0.286740 0.6611111 0.286740 0.6638889 0.286446 0.6666667 0.286151 0.6694444 0.285856 0.6722222 0.286151 0.6750000 0.287035 0.6777778 0.287624 0.6805556 0.287919 0.6833333 0.285562 0.6861111 0.283204 0.6888889 0.283204 0.6916667 0.282320 0.6944444 0.281731 0.6972222 0.280552 0.7000000 0.280552 0.7027778 0.280847 0.7055556 0.281436 0.7083333 0.281142 0.7111111 0.281436 0.7138889 0.280847 0.7166667 0.279963 0.7194444 0.279669 0.7222222 0.279963 0.7250000 0.279963 0.7277778 0.279374 0.7305556 0.279669 0.7333333 0.279079 0.7361111 0.280552 0.7388889 0.280258 0.7416667 0.280552 0.7444444 0.281142 0.7472222 0.279669 0.7500000 0.279079 0.7527778 0.279963 0.7555556 0.280552 0.7583333 0.280847 0.7611111 0.280552 0.7638889 0.279374 0.7666667 0.278490 0.7694444 0.278785 0.7722222 0.277606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
