kadgitub7/Leaky-Integrate-Fire---SNN-model-on-FPGA/(commit log)

2026-08-08 added output and current version
    created a semi working model. It is still not fully working and has some minor bugs but overall is good
    [lif_neuron.v, lif_neuron_tb.v]
2026-08-08 added minor corrections
    Now the full digital Leaky Integrate & Fire Neuron Model is complete
    [lif_neuron.v]
2026-08-20 added new low power model
2026-08-27 added schematics for low pass filter
2026-09-01 added buffer ota
    [norm_params.csv]
2026-09-04 add new snn framework
2026-10-07 corrected circuit files
2026-10-09 refined circuits
2026-10-16 correcting feature circuits
2026-10-19 new schematics
2026-11-14 added review stage of proposed design integration
